https-shubhamsahu/surang-sutra-vishwakarma/cad/mass-properties.md

# SURANG-SUTRA mass properties (CAD estimate)

Generated by `cad/mass_report.py` from `cad/mass-properties.json` (written by `build_surang.py`). Everything is a design calculation: printed, moulded and composite parts are CAD volume times density; bought parts use catalogue or baseline masses. Nothing has been weighed.

Densities (g/cm³): GFRP 2.0, CF 1.6, PA12 1.0, PETG 1.27, TPU 1.2, Al 2.7, Steel 7.85, FR4 1.85, PTFE 2.2. Al standoffs, steel pins/bearings, FR4 and PTFE are not in the brief, so standard values are used.

## Summary by baseline allocation

| Group | CAD-volume mass (g) | Catalogue / allowance (g) | Total (g) | Baseline allocation (g) | Delta (g) |
|---|---:|---:|---:|---:|---:|
| Cage | 444 | 11 | **455** | 400 | +55 |
| Frame + mounts | 234 | 25 | **259** | 300 | -41 |
| Motors | 0 | 248 | **248** | 250 | -2 |
| ESC + props | 0 | 60 | **60** | 100 | -40 |
| Battery | 0 | 490 | **490** | 490 | +0 |
| FC + avionics | 0 | 104 | **104** | 100 | +4 |
| Pi + cooler | 0 | 68 | **68** | 100 | -32 |
| Sensors + lights | 0 | 83 | **83** | 140 | -57 |
| Gas package | 26 | 63 | **89** | 100 | -11 |
| Cassette + 5 pucks | 146 | 82 | **229** | 170 | +59 |
| Wiring | 0 | 80 | **80** | 80 | +0 |
| Reserve | | | | 70 | |
| **All-up** | | | **2165** | **2300** (cap 2400) | **-235** vs cap |

- All-up CAD estimate **2.17 kg**: 65 g under the 2230 g of named allocations, 135 g under allocations + 70 g reserve, and 235 g under the 2.40 kg cap.
- Thrust check at the ≥ 6 kgf target: T/W = 6.0 / 2.17 = **2.77** (target ≥ 2.5).
- Over allocation: **Cage** (+55 g) and **Cassette + 5 pucks** (+59 g). Under: ESC + props, Pi, sensors, frame, gas.

## Line items

| Group | Item | Source | Material | Mass (g) |
|---|---|---|---|---:|
| Cage | Strut (120 off) | CAD | GFRP | 278.7 |
| Cage | Hub_M6 (30 off) | CAD | PA12 | 78.5 |
| Cage | TPU hub cap (40 off) | CAD | TPU | 30.1 |
| Cage | Hub_V5 (10 off) | CAD | PA12 | 26.7 |
| Cage | PoleHub_PosY | CAD | PA12 | 12.0 |
| Cage | PoleHub_NegY | CAD | PA12 | 12.0 |
| Cage | Bearing_6800_2RS_PosY | catalogue | bought | 5.5 |
| Cage | Bearing_6800_2RS_NegY | catalogue | bought | 5.5 |
| Cage | PoleCap_NegY | CAD | TPU | 3.2 |
| Cage | PoleCap_PosY | CAD | TPU | 3.2 |
| Frame + mounts | Plate_Bottom | CAD | CF | 27.4 |
| Frame + mounts | Plate_Top | CAD | CF | 27.4 |
| Frame + mounts | Axle | CAD | CF | 25.8 |
| Frame + mounts | Fasteners_allowance | catalogue | bought | 25.0 |
| Frame + mounts | Arm_FL | CAD | CF | 21.5 |
| Frame + mounts | Arm_FR | CAD | CF | 21.5 |
| Frame + mounts | Arm_RL | CAD | CF | 21.5 |
| Frame + mounts | Arm_RR | CAD | CF | 21.5 |
| Frame + mounts | Nose_Bracket | CAD | PA12 | 19.0 |
| Frame + mounts | Plate_Deck | CAD | CF | 14.0 |
| Frame + mounts | Standoffs_Stack_Posts | CAD | Al | 11.5 |
| Frame + mounts | LiDAR_Mast | CAD | PA12 | 10.9 |
| Frame + mounts | AxleClamp_PosY | CAD | PA12 | 4.5 |
| Frame + mounts | AxleClamp_NegY | CAD | PA12 | 4.5 |
| Frame + mounts | Standoffs_Deck_M3 | CAD | Al | 3.6 |
| Motors | Motor_FR | catalogue | bought | 62.0 |
| Motors | Motor_FL | catalogue | bought | 62.0 |
| Motors | Motor_RL | catalogue | bought | 62.0 |
| Motors | Motor_RR | catalogue | bought | 62.0 |
| ESC + props | ESC_4in1_6S | catalogue | bought | 28.0 |
| ESC + props | Prop_FR | catalogue | bought | 8.0 |
| ESC + props | Prop_FL | catalogue | bought | 8.0 |
| ESC + props | Prop_RL | catalogue | bought | 8.0 |
| ESC + props | Prop_RR | catalogue | bought | 8.0 |
| Battery | Battery_6S_3300 | catalogue | bought | 490.0 |
| FC + avionics | FC_Pixhawk6C_Mini | catalogue | bought | 39.2 |
| FC + avionics | PowerModule_Buck | catalogue | bought | 30.0 |
| FC + avionics | RadioPod_ESP32C3_LoRa_RX | catalogue | bought | 27.0 |
| FC + avionics | LoRa_Antenna_868 | catalogue | bought | 8.0 |
| Pi + cooler | Pi5_Board | catalogue | bought | 46.0 |
| Pi + cooler | Pi5_ActiveCooler | catalogue | bought | 22.0 |
| Sensors + lights | LiDAR_STL19P | catalogue | bought | 47.0 |
| Sensors + lights | Camera_IMX327 | catalogue | bought | 15.0 |
| Sensors + lights | Sensor_harness_mounts_allowance | catalogue | bought | 10.0 |
| Sensors + lights | Thermal_MLX90640 | catalogue | bought | 5.0 |
| Sensors + lights | IR_LED_850nm_R | catalogue | bought | 3.0 |
| Sensors + lights | IR_LED_850nm_L | catalogue | bought | 3.0 |
| Gas package | Gas_Sensors_O2_CO_H2S | catalogue | bought | 36.0 |
| Gas package | Gas_Pump | catalogue | bought | 25.0 |
| Gas package | Gas_FlowCell | CAD | PA12 | 22.2 |
| Gas package | GasInlet_Tube | CAD | PTFE | 3.4 |
| Gas package | GasInlet_Filter | catalogue | bought | 2.0 |
| Cassette + 5 pucks | 5 pucks: LiPo_1S_400 | catalogue | bought | 42.5 |
| Cassette + 5 pucks | 5 pucks: Shell_Lid | CAD | PETG | 33.7 |
| Cassette + 5 pucks | 5 pucks: Shell_Base | CAD | PETG | 28.9 |
| Cassette + 5 pucks | 5 pucks: PCB | CAD | FR4 | 26.8 |
| Cassette + 5 pucks | Cassette_Tube | CAD | PETG | 18.2 |
| Cassette + 5 pucks | 5 pucks: Bumper_TPU | CAD | TPU | 16.3 |
| Cassette + 5 pucks | Servo_MG90S | catalogue | bought | 13.4 |
| Cassette + 5 pucks | Cassette_TopCap | CAD | PA12 | 10.7 |
| Cassette + 5 pucks | 5 pucks: RFM95W_868 | catalogue | bought | 7.5 |
| Cassette + 5 pucks | BreakBeam_Collar | CAD | PA12 | 6.4 |
| Cassette + 5 pucks | 5 pucks: ESP32C3_MINI1 | catalogue | bought | 5.0 |
| Cassette + 5 pucks | 5 pucks: AprilTag | catalogue | bought | 4.0 |
| Cassette + 5 pucks | 5 pucks: Antenna_Stub | catalogue | bought | 3.0 |
| Cassette + 5 pucks | 5 pucks: Passives_LED_Hall | catalogue | bought | 3.0 |
| Cassette + 5 pucks | BreakBeam_IR_Pair | catalogue | bought | 2.0 |
| Cassette + 5 pucks | 5 pucks: ChargePads | catalogue | bought | 2.0 |
| Cassette + 5 pucks | Servo_Bracket | CAD | PA12 | 1.9 |
| Cassette + 5 pucks | Pin_Release | CAD | Steel | 1.4 |
| Cassette + 5 pucks | Pin_Capture | CAD | Steel | 1.2 |
| Cassette + 5 pucks | Escapement_Cam | CAD | PA12 | 0.9 |
| Wiring | Wiring_allowance | catalogue | bought | 80.0 |

## Centre of gravity

Origin = cage centre = axle centreline. X forward (nose), Y along the axle, Z up. Cage in its rest pose.

| Assembly | Mass (g) | CG x (mm) | CG y (mm) | CG z (mm) |
|---|---:|---:|---:|---:|
| All-up | 2165 | 0.0 | 4.6 | -12.4 |
| Hanging core (everything except the cage) | 1710 | 0.0 | 5.8 | -15.7 |
| Cage (rotates on the bearings) | 455 | 0.0 | 0.0 | 0.0 |

- The battery is placed at x = -9.0 mm by the build script so the hanging core balances fore-aft (x_CG = 0), which keeps the frame level on the axle.
- The hanging core CG sits **15.7 mm below the axle**: pendulum-stable but a short arm (restoring moment ≈ 0.26 N·m per radian of tilt). Lowering the battery or cassette would lengthen it.
- Lateral CG y = +5.8 mm (core) comes from the cassette offset to +54 mm (see README, puck exit). It falls as pucks are dropped; the FC trims it in flight, or the gas package can move further to −Y.

Inertia about the all-up CG (kg·m², solids at uniform density, bought blocks scaled to catalogue mass):

| | x | y | z |
|---|---:|---:|---:|
| x | 0.0338 | 0.0000 | -0.0003 |
| y | 0.0000 | 0.0307 | 0.0008 |
| z | -0.0003 | 0.0008 | 0.0360 |

## SUTRA puck (one)

| Part | Source | Material | Mass (g) |
|---|---|---|---:|
| Shell_Base | CAD | PETG | 5.8 |
| Shell_Lid | CAD | PETG | 6.7 |
| Bumper_TPU | CAD | TPU | 3.3 |
| PCB | CAD | FR4 | 5.4 |
| LiPo_1S_400 | catalogue | bought | 8.5 |
| ESP32C3_MINI1 | catalogue | bought | 1.0 |
| RFM95W_868 | catalogue | bought | 1.5 |
| Antenna_Stub | catalogue | bought | 0.6 |
| ChargePads | catalogue | bought | 0.4 |
| Passives_LED_Hall | catalogue | bought | 0.6 |
| screws + tag label (allowance) | catalogue | | 0.8 |
| **Total** | | | **34.5** (target ≤ 30) |

Puck CG 8.0 mm above the base. Getting under 30 g, calculated: PETG walls 1.4 → 1.0 mm (about −3.5 g) and a 1.0 mm PCB instead of 1.6 mm (about −2 g) give about 29 g.

Catalogue masses used (approximate, class values, check against the purchased parts): 2809 motor 62 g, HQ 7x4x3 prop 8 g, 4-in-1 6S ESC 28 g, 6S 3300 mAh pack 490 g (baseline), Pixhawk 6C Mini 39.2 g, power module + buck 30 g, ESP32-C3 + RFM95W + receiver 27 g, 868 MHz antenna 8 g, Raspberry Pi 5 46 g, active cooler 22 g, STL-19P LiDAR 47 g, IMX327 module 15 g, MLX90640 5 g, IR LED + optic 3 g each, gas cells 36 g (3), sampling pump 25 g, MG90S 13.4 g, 6800-2RS bearing 5.5 g, 1S 400 mAh LiPo 8.5 g. Allowances: fasteners 25 g, sensor harness/mounts 10 g, wiring 80 g (baseline).
