https-shubhamsahu/surang-sutra-vishwakarma/electronics/exports/surang-avionics-deck.png

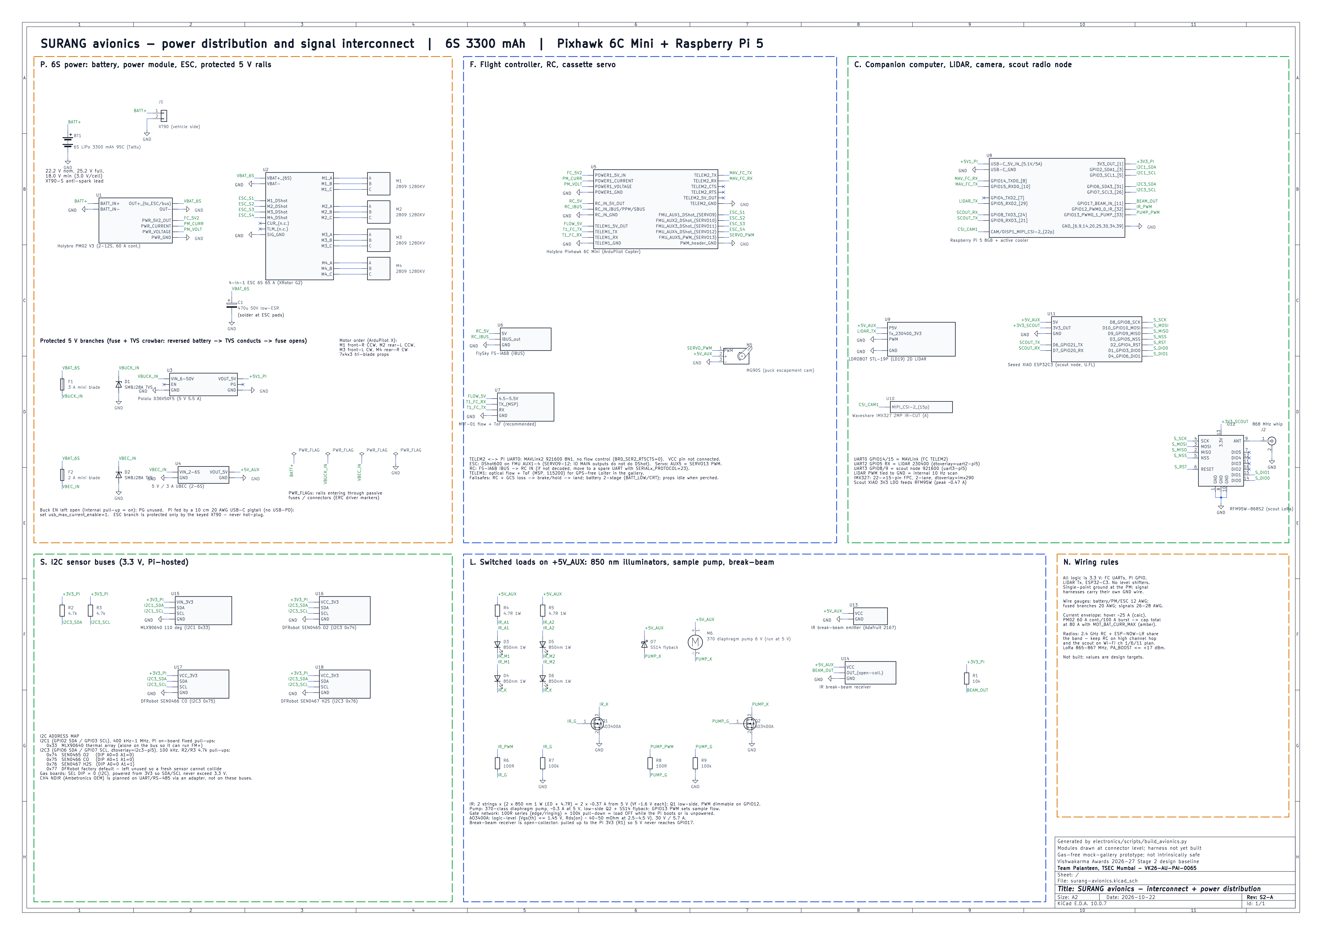
electronics/exports/surang-avionics-deck.png
