https-shubhamsahu/surang-sutra-vishwakarma/electronics/exports/sutra-puck-deck.png

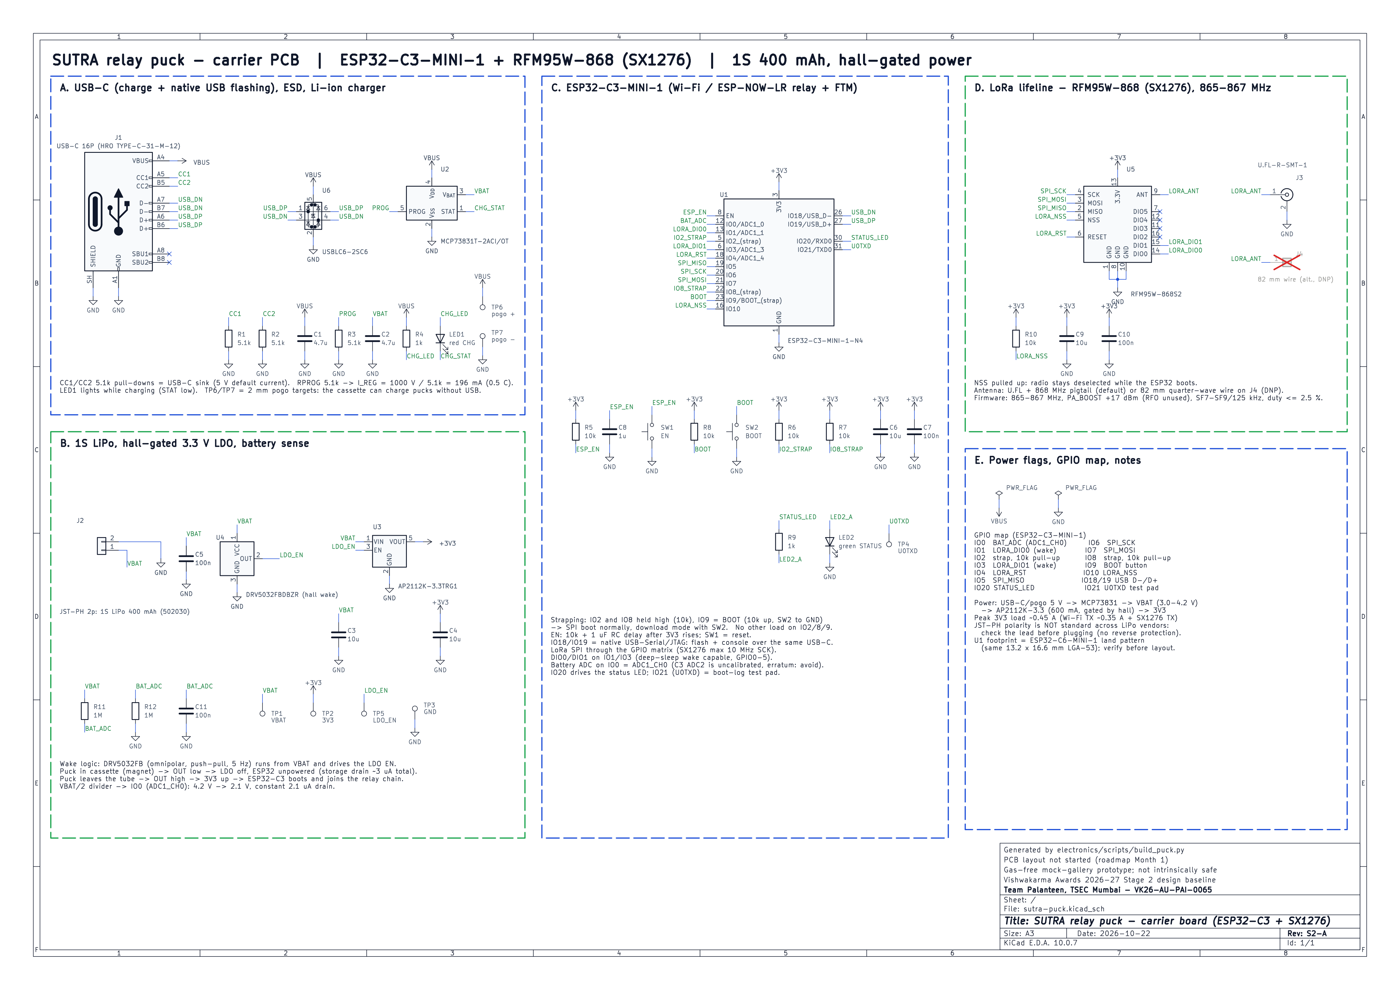
electronics/exports/sutra-puck-deck.png
