https-shubhamsahu/surang-sutra-vishwakarma/electronics/pinmap.png

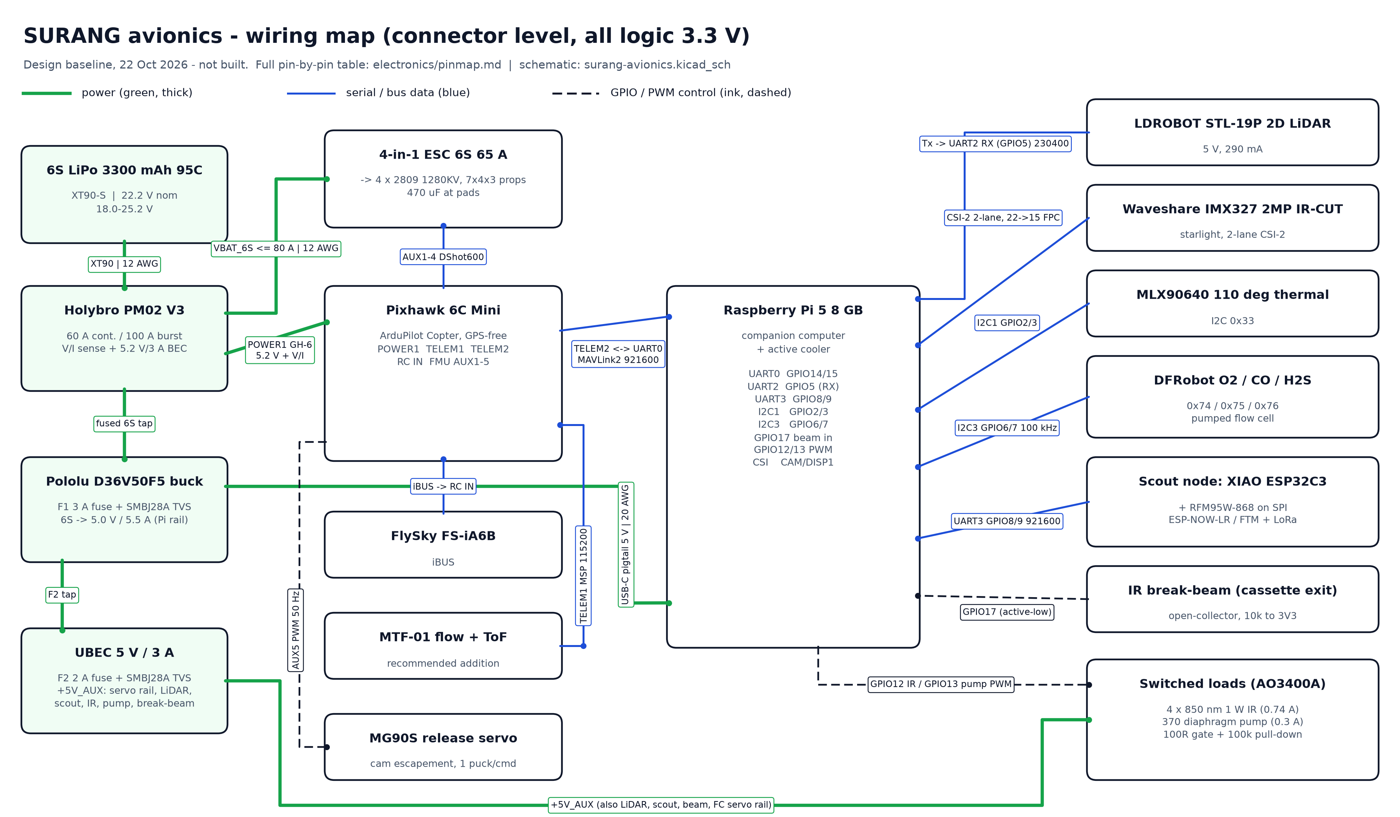
electronics/pinmap.png
