https-shubhamsahu/surang-sutra-vishwakarma/electronics/power-budget.png

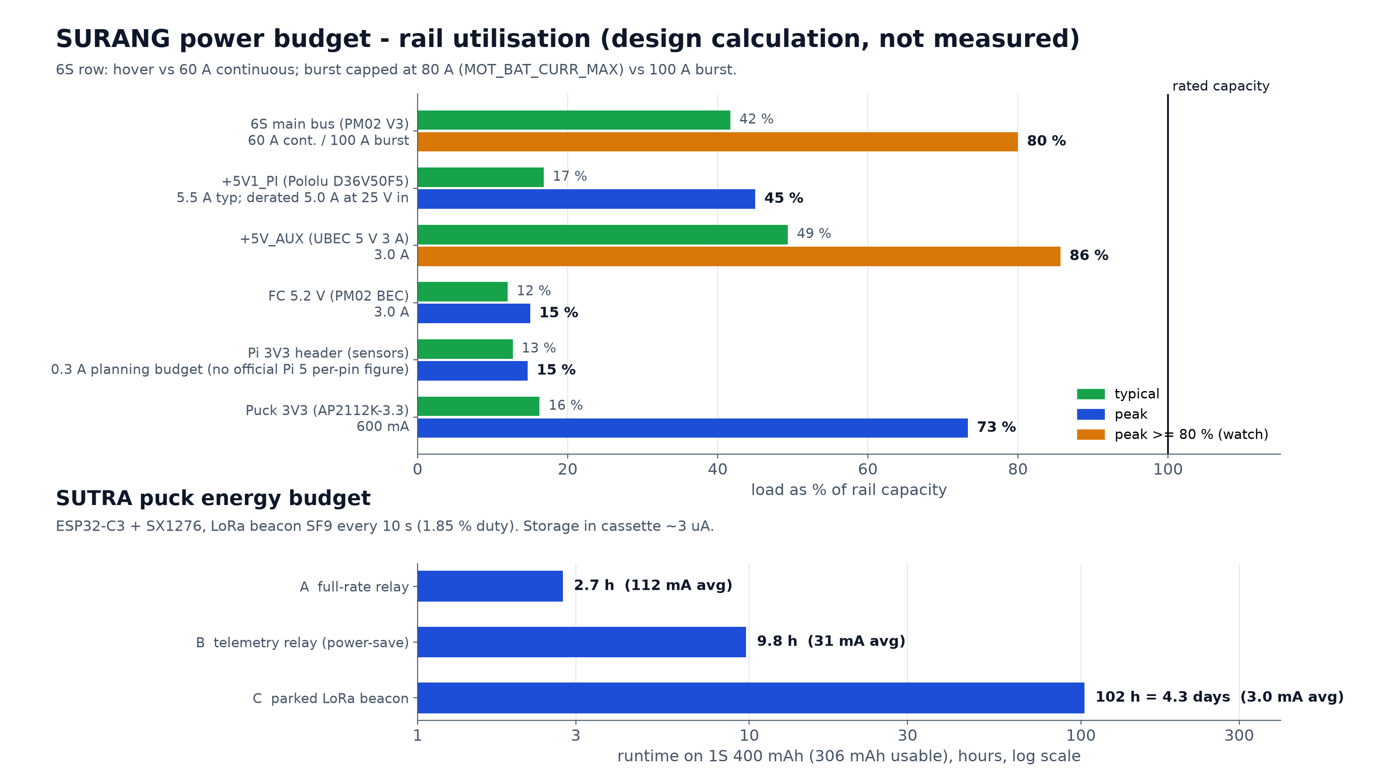
electronics/power-budget.png
