https-shubhamsahu/surang-sutra-vishwakarma/fea/figures/fea-cage-stress.png

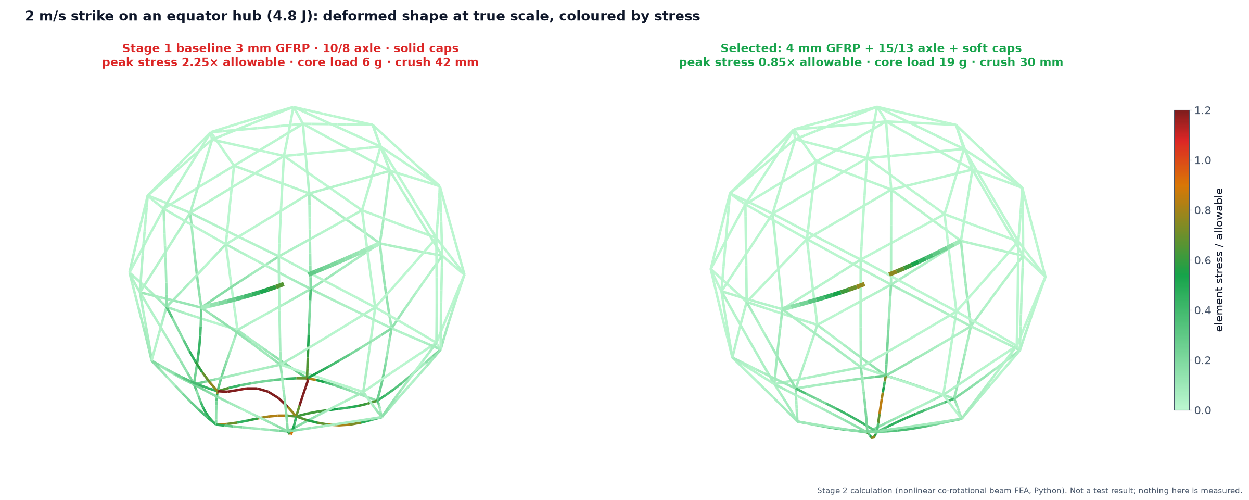
fea/figures/fea-cage-stress.png
