https-shubhamsahu/surang-sutra-vishwakarma/fea/figures/fea-convergence.png

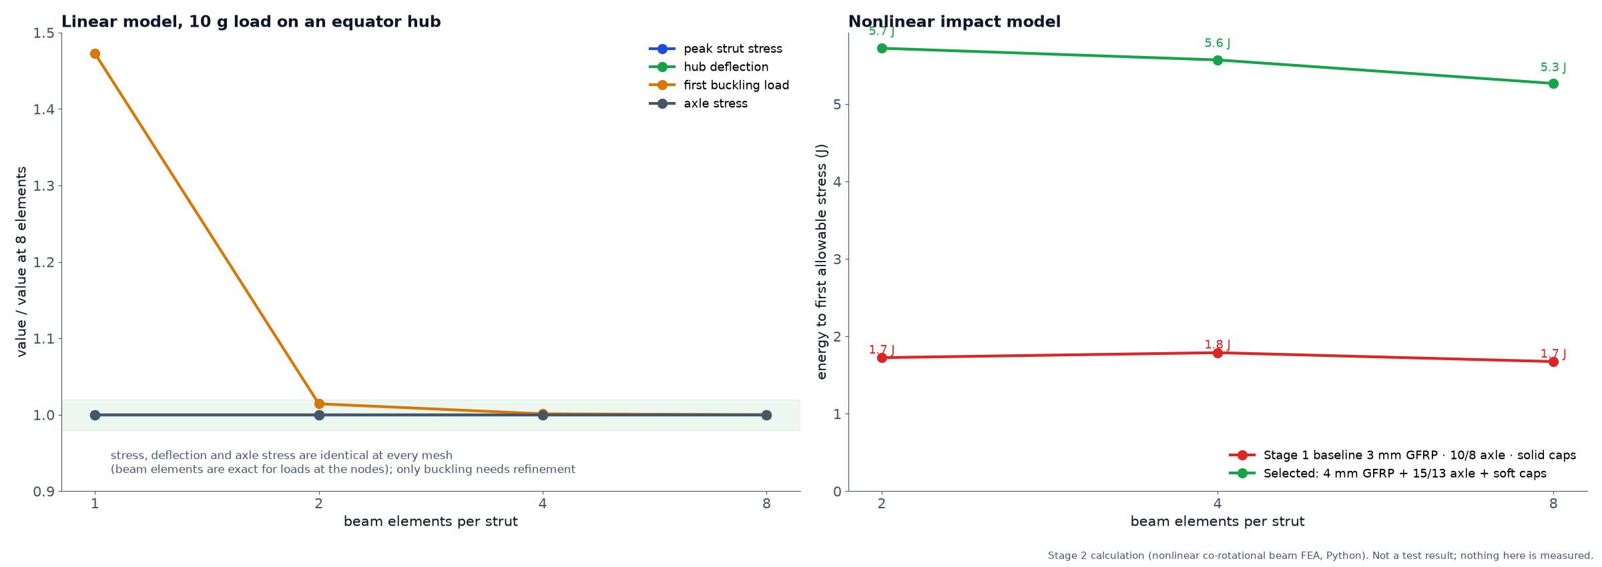
fea/figures/fea-convergence.png
