https-shubhamsahu/surang-sutra-vishwakarma/fea/figures/fea-design-ladder.png

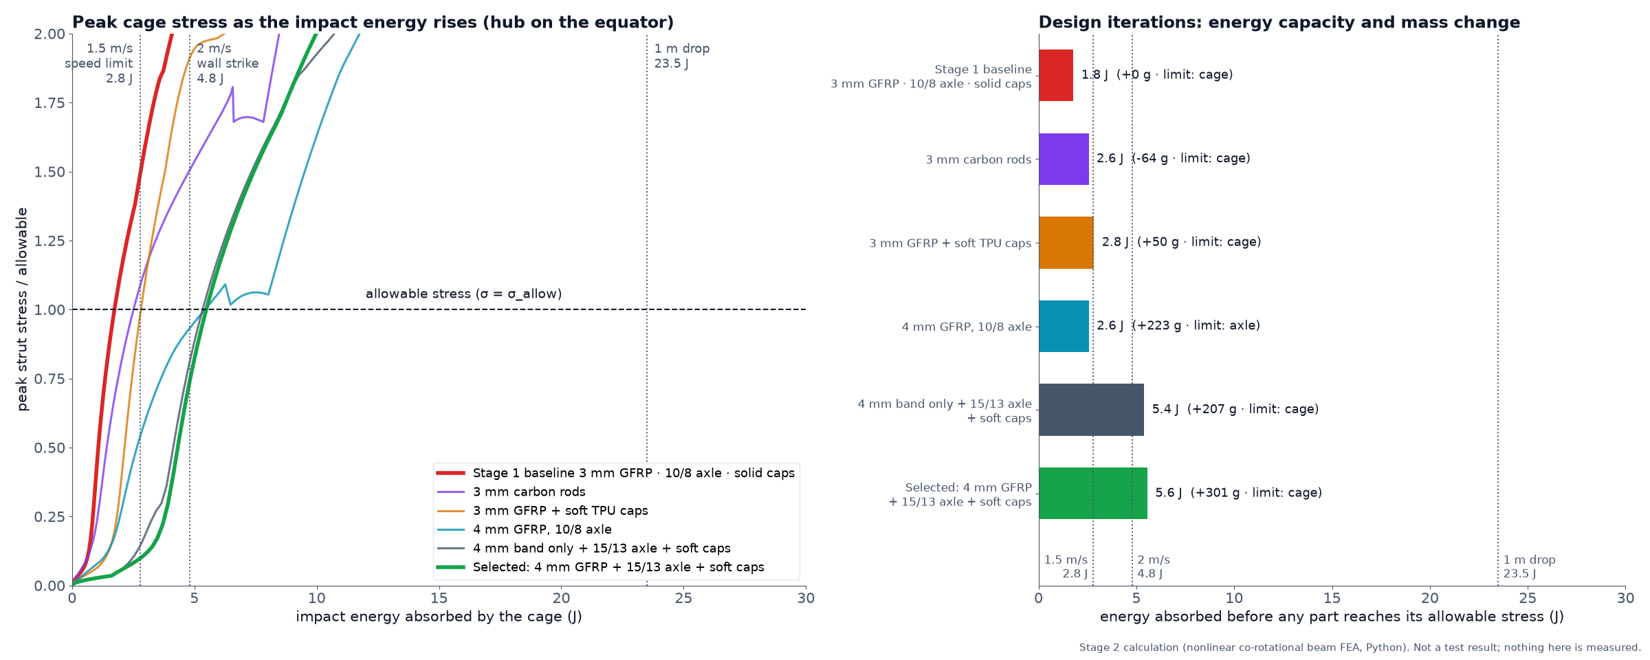
fea/figures/fea-design-ladder.png
