https-shubhamsahu/surang-sutra-vishwakarma/renders/_raw/bottom.png

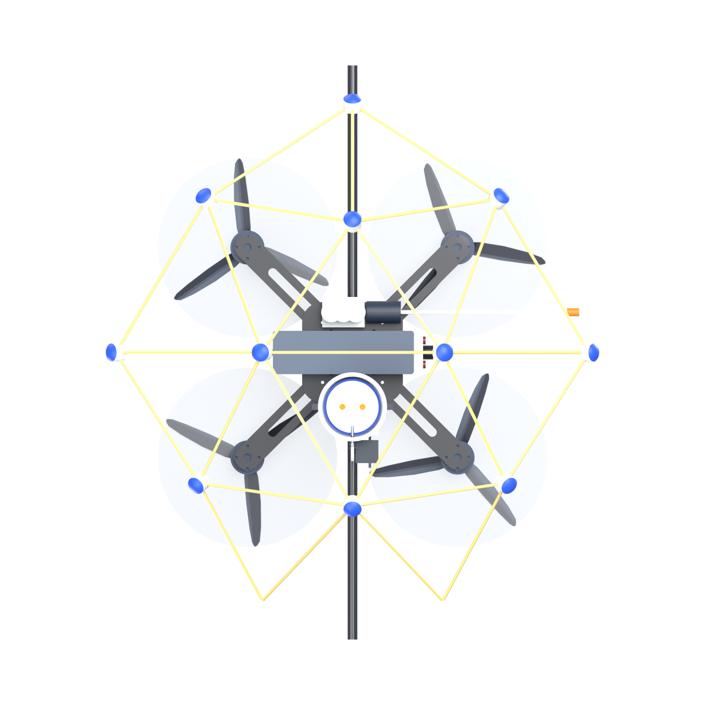
renders/_raw/bottom.png
