https-shubhamsahu/surang-sutra-vishwakarma/renders/_raw/cutaway.png

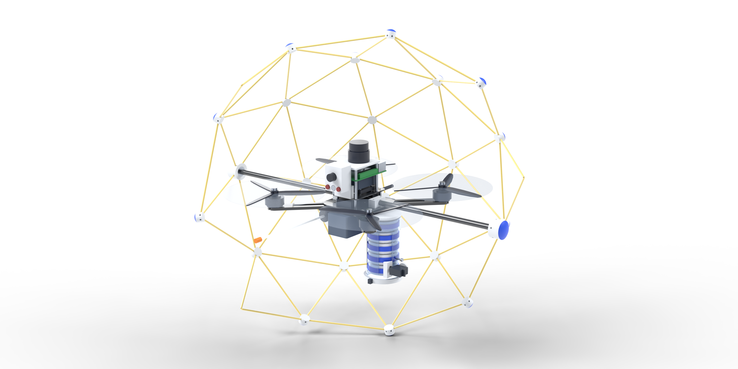
renders/_raw/cutaway.png
