https-shubhamsahu/surang-sutra-vishwakarma/renders/_raw/exploded.png

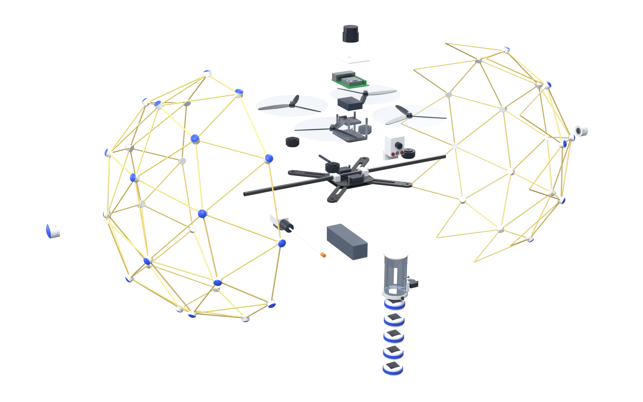
renders/_raw/exploded.png
