https-shubhamsahu/surang-sutra-vishwakarma/renders/_raw/hero.png

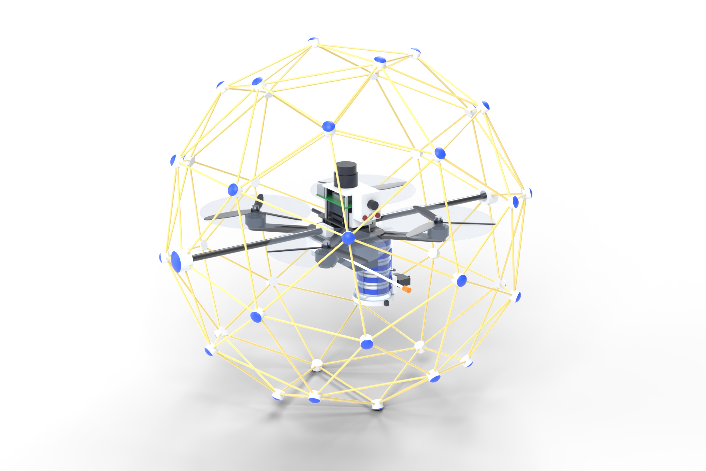
renders/_raw/hero.png
