https-shubhamsahu/surang-sutra-vishwakarma/renders/_raw/plan.png

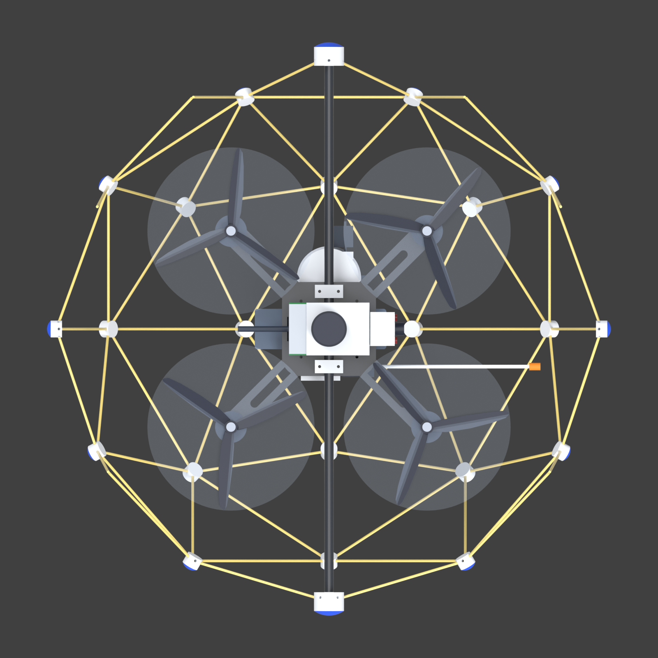
renders/_raw/plan.png
