https-shubhamsahu/surang-sutra-vishwakarma/renders/_raw/puck.png

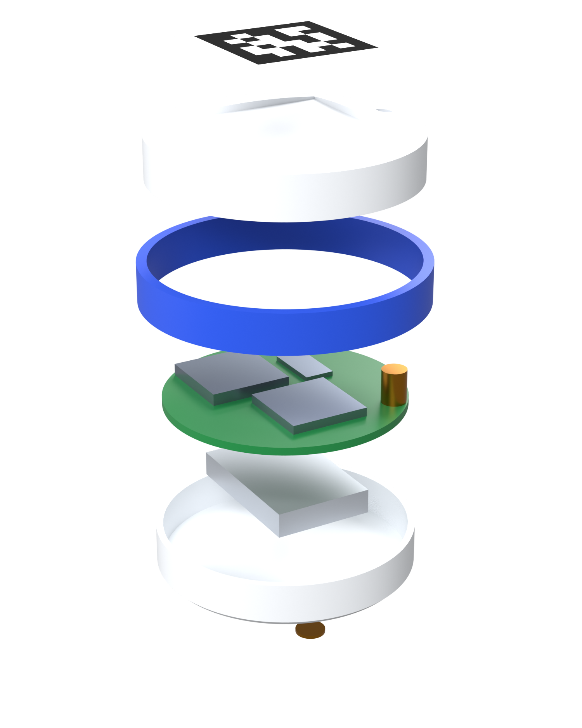
renders/_raw/puck.png
