https-shubhamsahu/surang-sutra-vishwakarma/renders/_raw/side.png

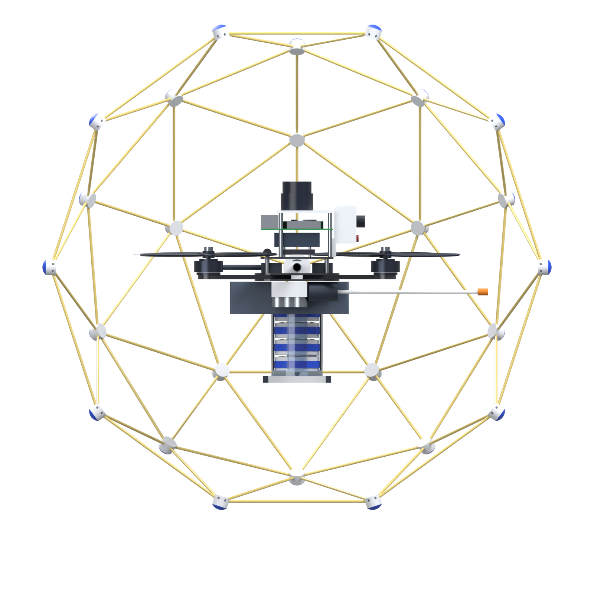
renders/_raw/side.png
