https-shubhamsahu/surang-sutra-vishwakarma/renders/freecad-ui.png

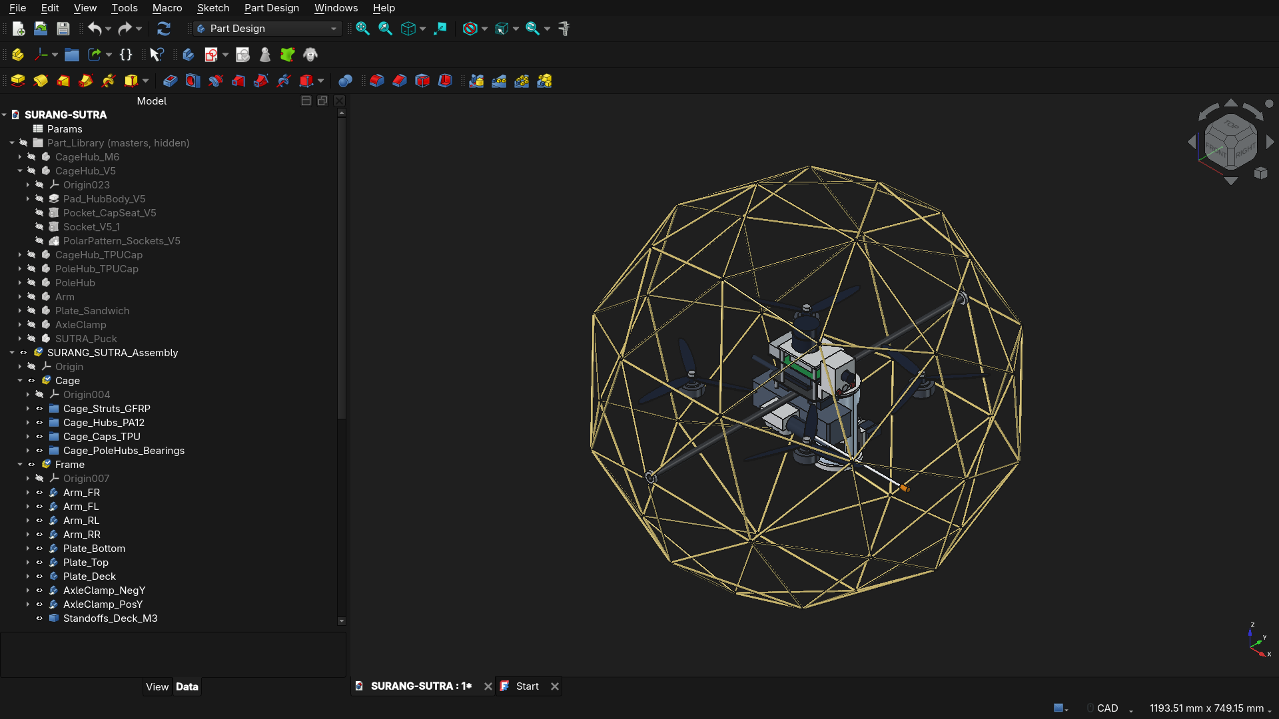
renders/freecad-ui.png
