https-shubhamsahu/surang-sutra-vishwakarma/renders/puck-exit-check.png

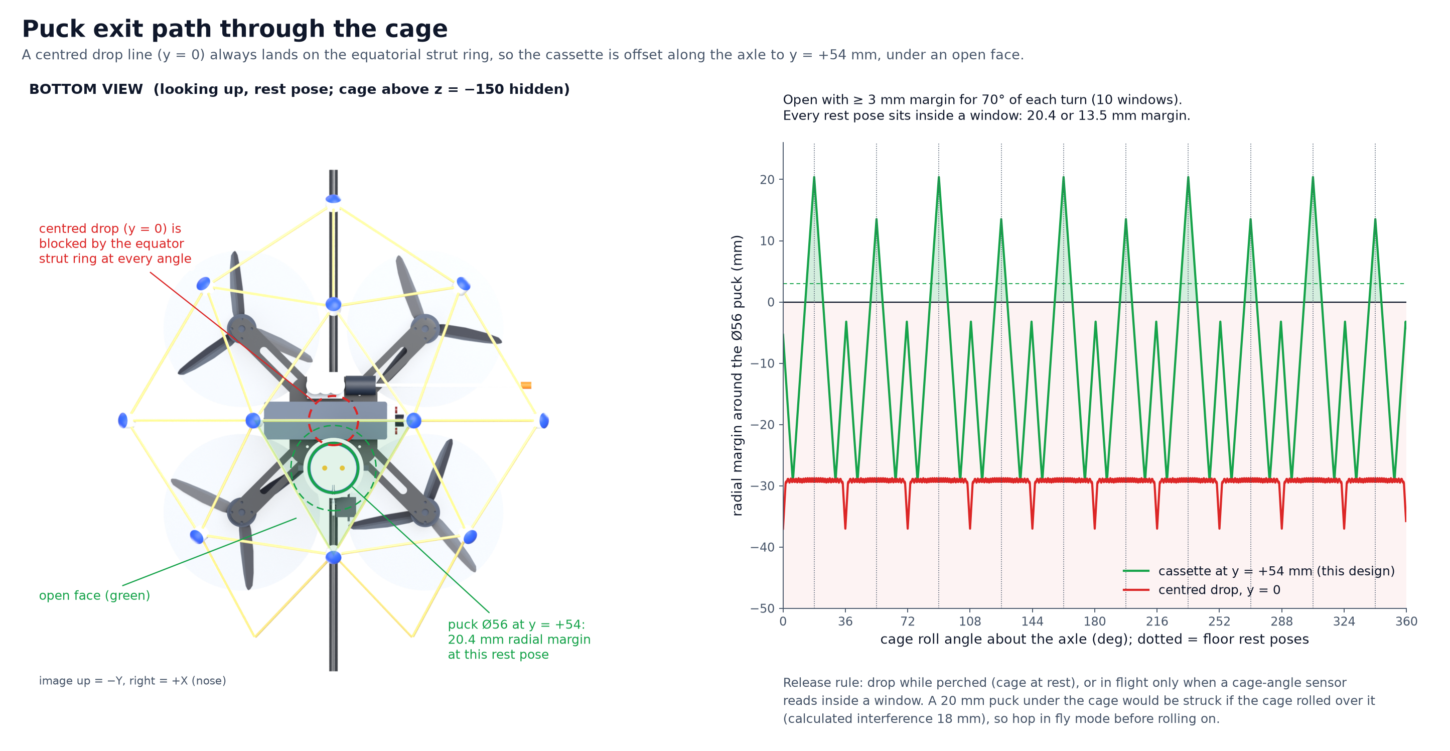
renders/puck-exit-check.png
