https-shubhamsahu/surang-sutra-vishwakarma/renders/surang-cutaway.png

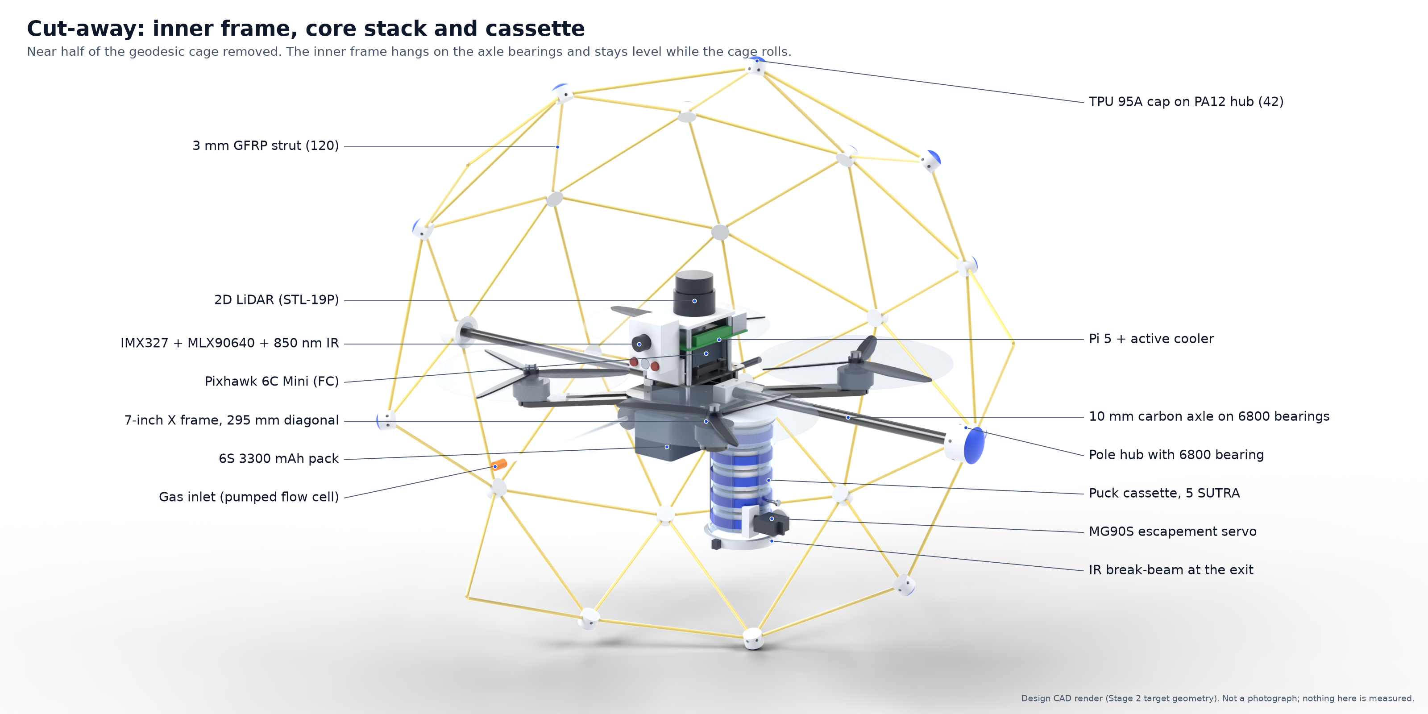
renders/surang-cutaway.png
