https-shubhamsahu/surang-sutra-vishwakarma/renders/surang-exploded.png

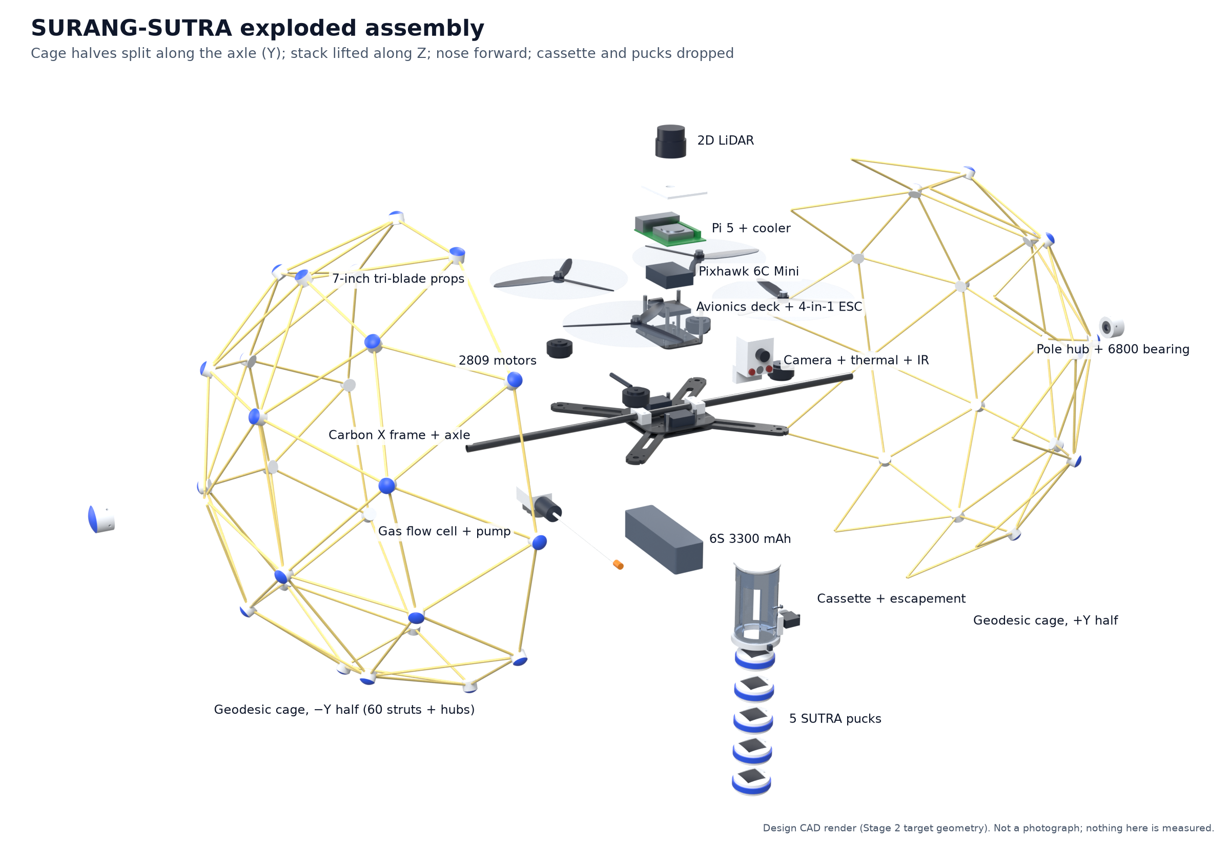
renders/surang-exploded.png
