https-shubhamsahu/surang-sutra-vishwakarma/renders/surang-side-plan-dimensions.png

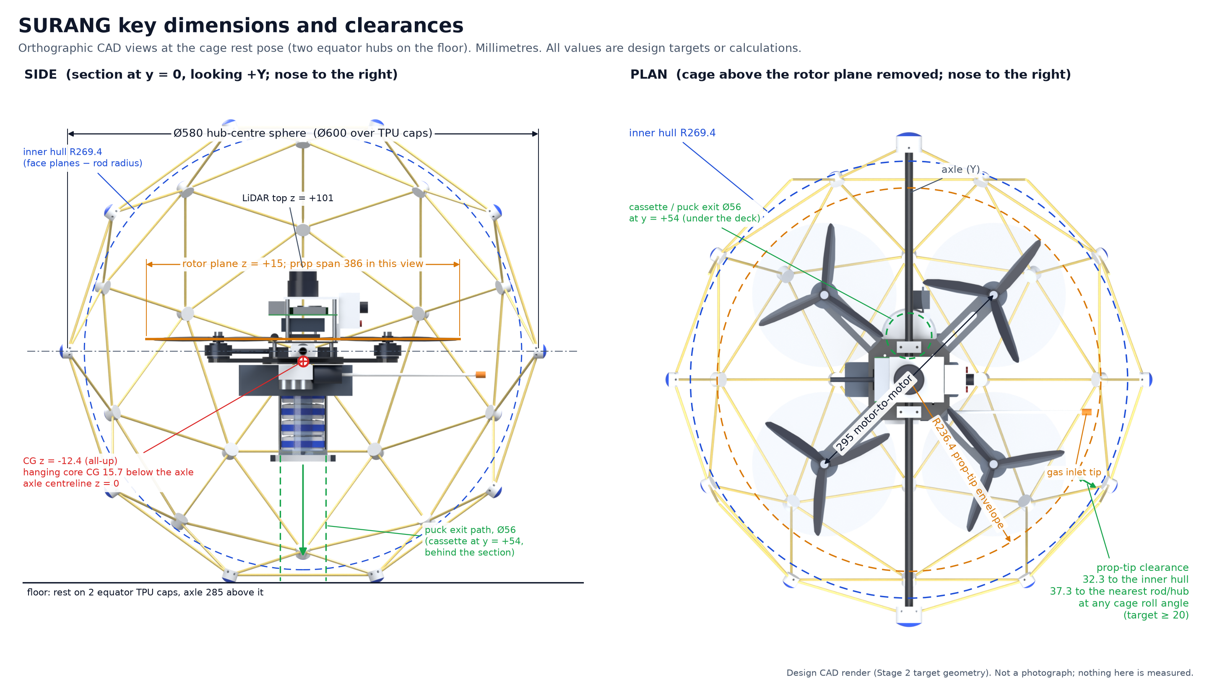
renders/surang-side-plan-dimensions.png
