https-shubhamsahu/surang-sutra-vishwakarma/renders/sutra-puck-exploded.png

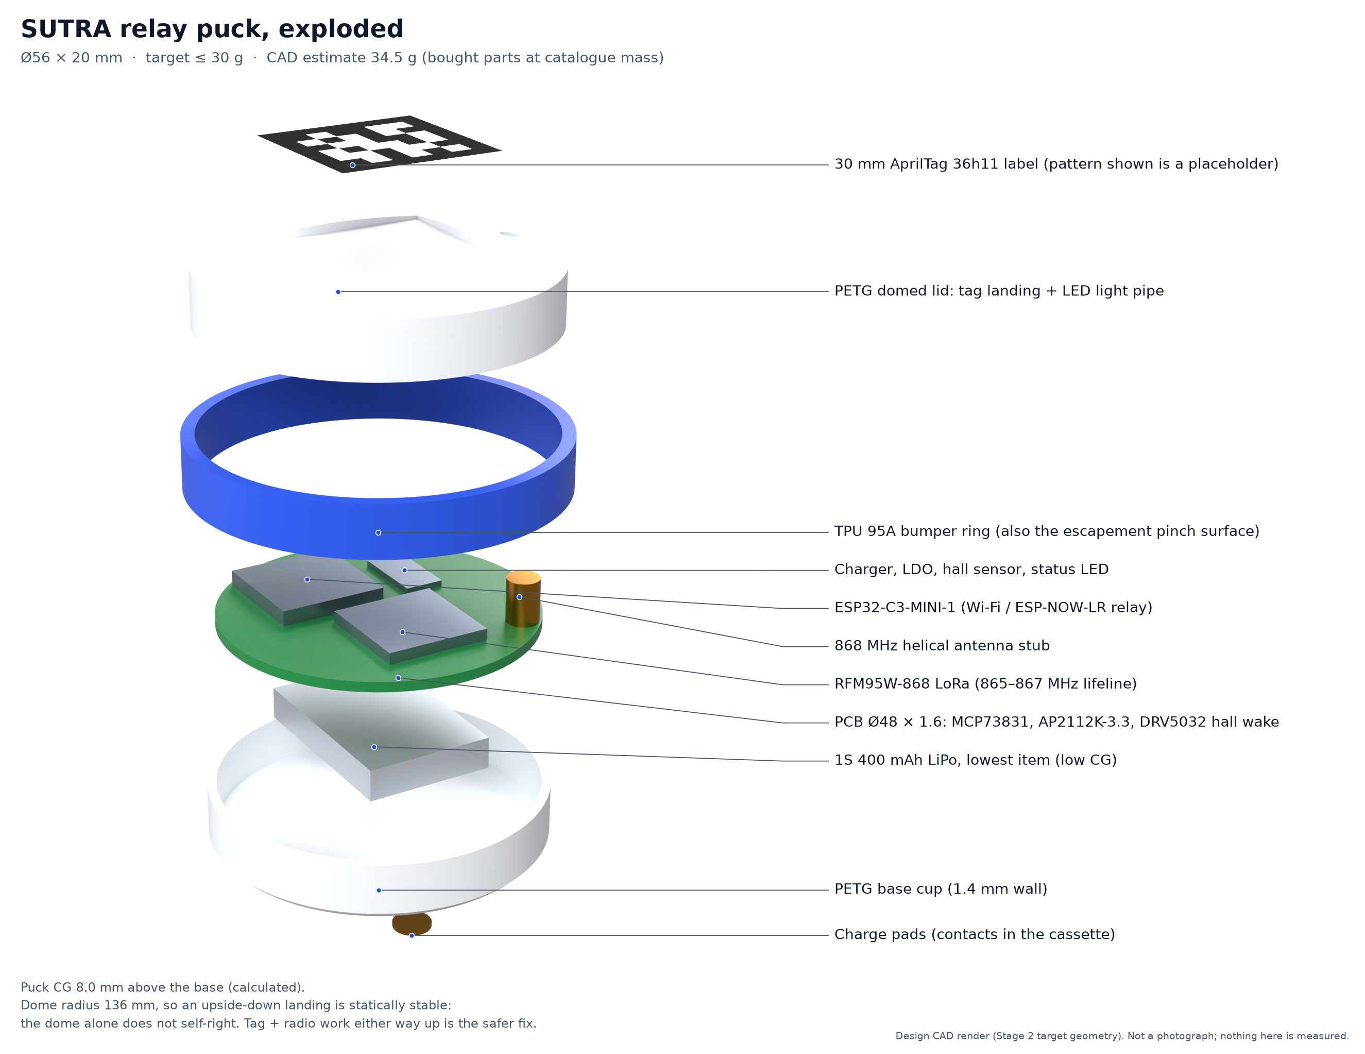
renders/sutra-puck-exploded.png
