https-shubhamsahu/surang-sutra-vishwakarma/electronics/exports/surang-avionics-bom-kicad.csv

Refs | Value | MPN | Footprint | Qty | DNP
BT1 | 6S LiPo 3300 mAh 95C (Tattu) | TAS33006S95X9 |  | 1
C1 | 470u 50V low-ESR | Panasonic EEU-FR1H471 | Capacitor_THT:CP_Radial_D10.0mm_P5.00mm | 1
D1,D2 | SMBJ28A TVS | SMBJ28A | Diode_SMD:D_SMB | 2
D3,D4,D5,D6 | 850nm 1W |  | LED_SMD:LED_1W_3W_R8 | 4
D7 | SS14 flyback | SS14 | Diode_SMD:D_SMA | 1
F1 | 3 A mini blade | Littelfuse 0297003 | Fuse:Fuse_Blade_Mini_directSolder | 1
F2 | 2 A mini blade | Littelfuse 0297002 | Fuse:Fuse_Blade_Mini_directSolder | 1
J1 | XT90 (vehicle side) | AMASS XT90H | Connector_AMASS:AMASS_XT90PW-M_1x02_P10.90mm_Horizontal | 1
J2 | 868 MHz whip |  | Connector_Coaxial:U.FL_Hirose_U.FL-R-SMT-1_Vertical | 1
M1,M2,M3,M4 | 2809 1280KV | GEPRC SPEEDX2 2809 1280KV |  | 4
M5 | MG90S (puck escapement cam) | MG90S |  | 1
M6 | 370 diaphragm pump 6 V (run at 5 V) | 370 micro air pump |  | 1
Q1,Q2 | AO3400A | AO3400A | Package_TO_SOT_SMD:SOT-23 | 2
R1 | 10k |  | Resistor_SMD:R_0603_1608Metric | 1
R2,R3 | 4.7k |  | Resistor_SMD:R_0603_1608Metric | 2
R4,R5 | 4.7R 1W | 2512 4.7R 1W | Resistor_SMD:R_2512_6332Metric | 2
R6,R8 | 100R |  | Resistor_SMD:R_0603_1608Metric | 2
R7,R9 | 100k |  | Resistor_SMD:R_0603_1608Metric | 2
U1 | Holybro PM02 V3 (2-12S, 60 A cont.) | Holybro PM02 V3 |  | 1
U2 | 4-in-1 ESC 6S 65 A (XRotor G2) | Hobbywing XRotor G2 65A 4in1 |  | 1
U3 | Pololu D36V50F5 (5 V 5.5 A) | Pololu #4091 |  | 1
U4 | 5 V / 3 A UBEC (2-6S) | ReadytoSky 2-6S 5V3A UBEC |  | 1
U5 | Holybro Pixhawk 6C Mini (ArduPilot Copter) | Holybro Pixhawk 6C Mini |  | 1
U6 | FlySky FS-iA6B (iBUS) | FlySky FS-iA6B |  | 1
U7 | MTF-01 flow + ToF (recommended) | MicoAir MTF-01 |  | 1
U8 | Raspberry Pi 5 8GB + active cooler | SC1112 |  | 1
U9 | LDROBOT STL-19P (LD19) 2D LiDAR | STL-19P / D500 kit |  | 1
U10 | Waveshare IMX327 2MP IR-CUT (A) | Waveshare 23752 |  | 1
U11 | Seeed XIAO ESP32C3 (scout node, U.FL) | Seeed 113991054 |  | 1
U12 | RFM95W-868S2 (scout LoRa) | RFM95W-868S2 | RF_Module:HOPERF_RFM9XW_SMD | 1
U13 | IR break-beam emitter (Adafruit 2167) | Adafruit 2167 |  | 1
U14 | IR break-beam receiver | Adafruit 2167 |  | 1
U15 | MLX90640 110 deg (I2C1 0x33) | 7Semi MLX90640 110deg |  | 1
U16 | DFRobot SEN0465 O2 (I2C3 0x74) | DFRobot SEN0465 |  | 1
U17 | DFRobot SEN0466 CO (I2C3 0x75) | DFRobot SEN0466 |  | 1
U18 | DFRobot SEN0467 H2S (I2C3 0x76) | DFRobot SEN0467 |  | 1
