https-shubhamsahu/surang-sutra-vishwakarma/electronics/exports/sutra-puck-bom-kicad.csv

Refs | Value | MPN | Footprint | Qty | DNP
C1,C2 | 4.7u | X5R 10V 0805 | Capacitor_SMD:C_0805_2012Metric | 2
C3,C4,C6,C9 | 10u | X5R 10V 0805 | Capacitor_SMD:C_0805_2012Metric | 4
C5,C7,C10,C11 | 100n | X7R 16V 0603 100n | Capacitor_SMD:C_0603_1608Metric | 4
C8 | 1u | X7R 16V 0603 1u | Capacitor_SMD:C_0603_1608Metric | 1
J1 | USB-C 16P (HRO TYPE-C-31-M-12) | TYPE-C-31-M-12 | Connector_USB:USB_C_Receptacle_HRO_TYPE-C-31-M-12 | 1
J2 | JST-PH 2p: 1S LiPo 400 mAh (502030) | S2B-PH-SM4-TB | Connector_JST:JST_PH_S2B-PH-SM4-TB_1x02-1MP_P2.00mm_Horizontal | 1
J3 | U.FL-R-SMT-1 | U.FL-R-SMT-1(10) | Connector_Coaxial:U.FL_Hirose_U.FL-R-SMT-1_Vertical | 1
J4 | 82 mm wire (alt., DNP) |  | Connector_Wire:SolderWire-0.127sqmm_1x01_D0.48mm_OD1mm | 1 | DNP
LED1 | red CHG | red 0603 | LED_SMD:LED_0603_1608Metric | 1
LED2 | green STATUS | green 0603 | LED_SMD:LED_0603_1608Metric | 1
R1,R2,R3 | 5.1k | 0603 5.1k 1% | Resistor_SMD:R_0603_1608Metric | 3
R4,R9 | 1k | 0603 1k 1% | Resistor_SMD:R_0603_1608Metric | 2
R5,R6,R7,R8,R10 | 10k | 0603 10k 1% | Resistor_SMD:R_0603_1608Metric | 5
R11,R12 | 1M | 0603 1M 1% | Resistor_SMD:R_0603_1608Metric | 2
SW1 | EN | C&K KMR221G | Button_Switch_SMD:SW_Push_1P1T_NO_CK_KMR2 | 1
SW2 | BOOT | C&K KMR221G | Button_Switch_SMD:SW_Push_1P1T_NO_CK_KMR2 | 1
U1 | ESP32-C3-MINI-1-N4 | ESP32-C3-MINI-1-N4 | RF_Module:ESP32-C6-MINI-1 | 1
U2 | MCP73831T-2ACI/OT | MCP73831T-2ACI/OT | Package_TO_SOT_SMD:SOT-23-5 | 1
U3 | AP2112K-3.3TRG1 | AP2112K-3.3TRG1 | Package_TO_SOT_SMD:SOT-23-5 | 1
U4 | DRV5032FBDBZR (hall wake) | DRV5032FBDBZR | Package_TO_SOT_SMD:SOT-23 | 1
U5 | RFM95W-868S2 | RFM95W-868S2 | RF_Module:HOPERF_RFM9XW_SMD | 1
U6 | USBLC6-2SC6 | USBLC6-2SC6 | Package_TO_SOT_SMD:SOT-23-6 | 1
