https-shubhamsahu/surang-sutra-vishwakarma/cad/mesh/assembly.obj

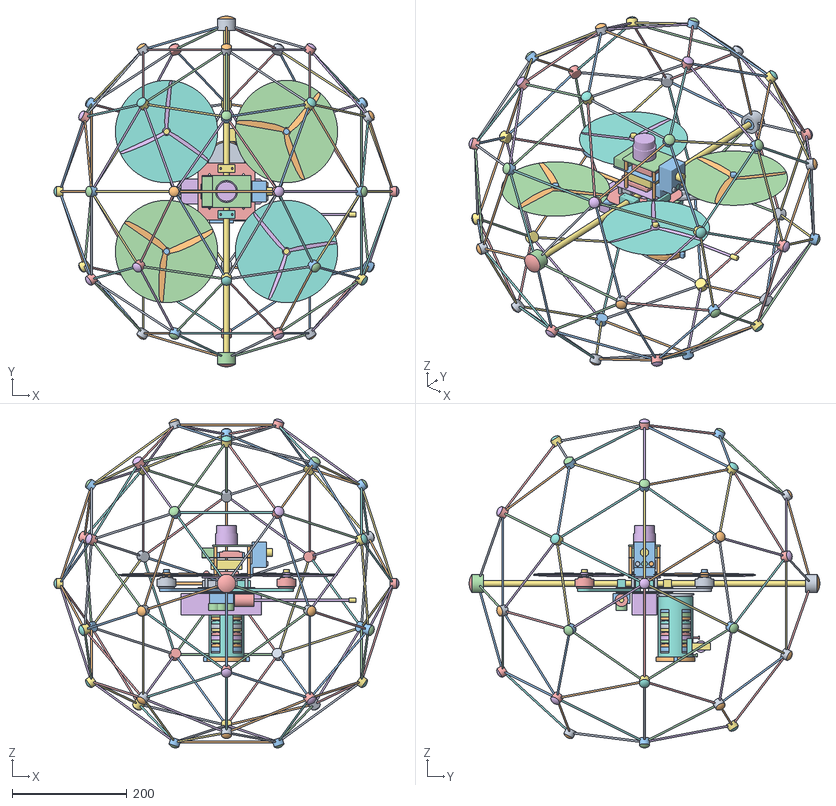
[picture p21: CAD file, 2026-10-24]
cad/mesh/assembly.obj
600.0 x 610.0 x 571.8
Strut_000
Strut_001
Strut_002
Strut_003
Strut_004
Strut_005
Strut_006
Strut_007
Strut_008
Strut_009
Strut_010
Strut_011
Strut_012
Strut_013
Strut_014
Strut_015
Strut_016
Strut_017
Strut_018
Strut_019
Strut_020
Strut_021
Strut_022
Strut_023
Strut_024
Strut_025
Strut_026
Strut_027
Strut_028
Strut_029
Strut_030
Strut_031
Strut_032
Strut_033
Strut_034
Strut_035
Strut_036
Strut_037
Strut_038
Strut_039
Strut_040
Strut_041
Strut_042
Strut_043
Strut_044
Strut_045
Strut_046
Strut_047
Strut_048
Strut_049
Strut_050
Strut_051
Strut_052
Strut_053
Strut_054
Strut_055
Strut_056
Strut_057
Strut_058
Strut_059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
