https-shubhamsahu/surang-sutra-vishwakarma/cad/step/pole-hub.step

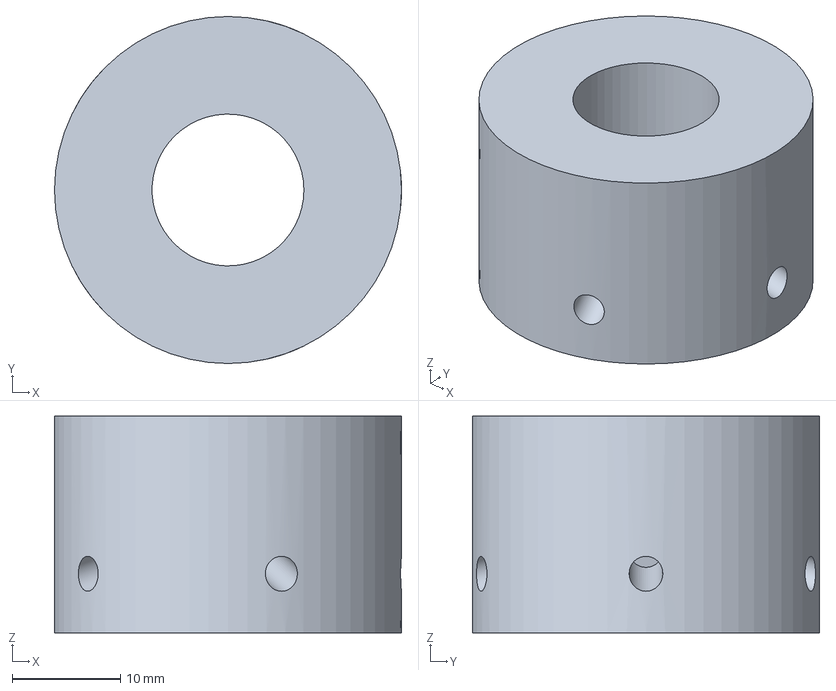
[picture p23: CAD file, 2026-10-24]
cad/step/pole-hub.step
32.0 x 32.0 x 20.0 mm
