https-shubhamsahu/surang-sutra-vishwakarma/cad/stl/puck-shell-lid.stl

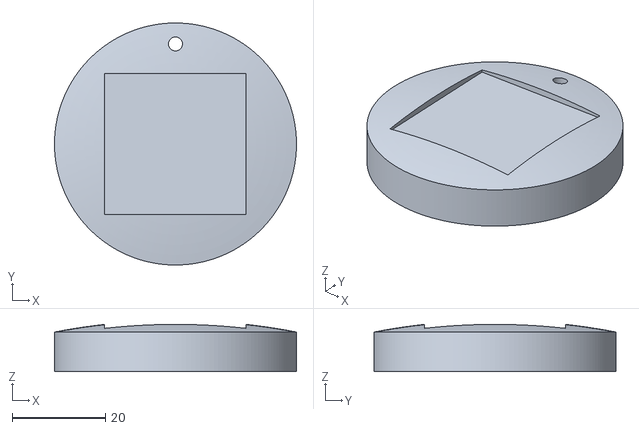
[picture p24: CAD file, 2026-10-24]
cad/stl/puck-shell-lid.stl
52.0 x 52.0 x 10.2
