https-shubhamsahu/surang-sutra-vishwakarma/cad/mesh/puck.obj

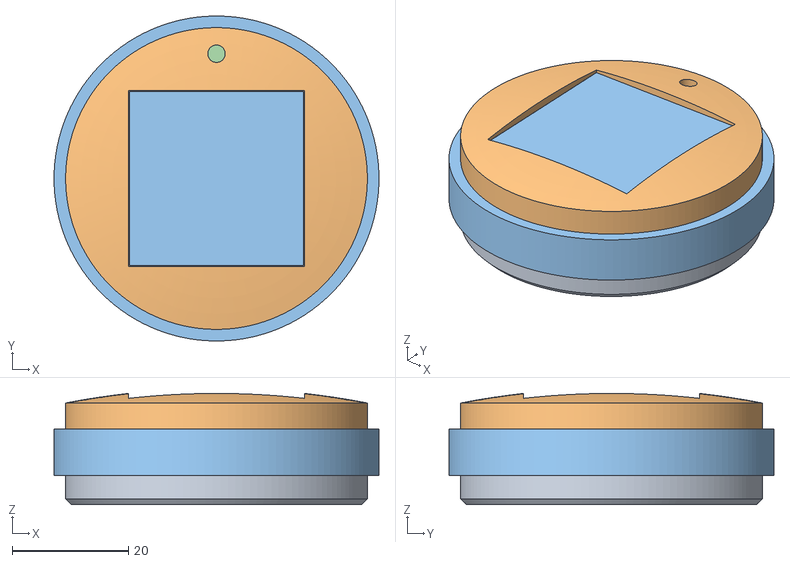
[picture p26: CAD file, 2026-10-24]
cad/mesh/puck.obj
56.0 x 56.0 x 19.2
Puck_Shell_Base
Puck_Shell_Lid
Puck_Bumper_TPU
Puck_PCB
Puck_LiPo_1S_400
Puck_ESP32C3_MINI1
Puck_RFM95W_868
Puck_Antenna_Stub
Puck_ChargePads
Puck_Passives_LED_Hall
Puck_AprilTag
