https-shubhamsahu/surang-sutra-vishwakarma/cad/step/cage.step

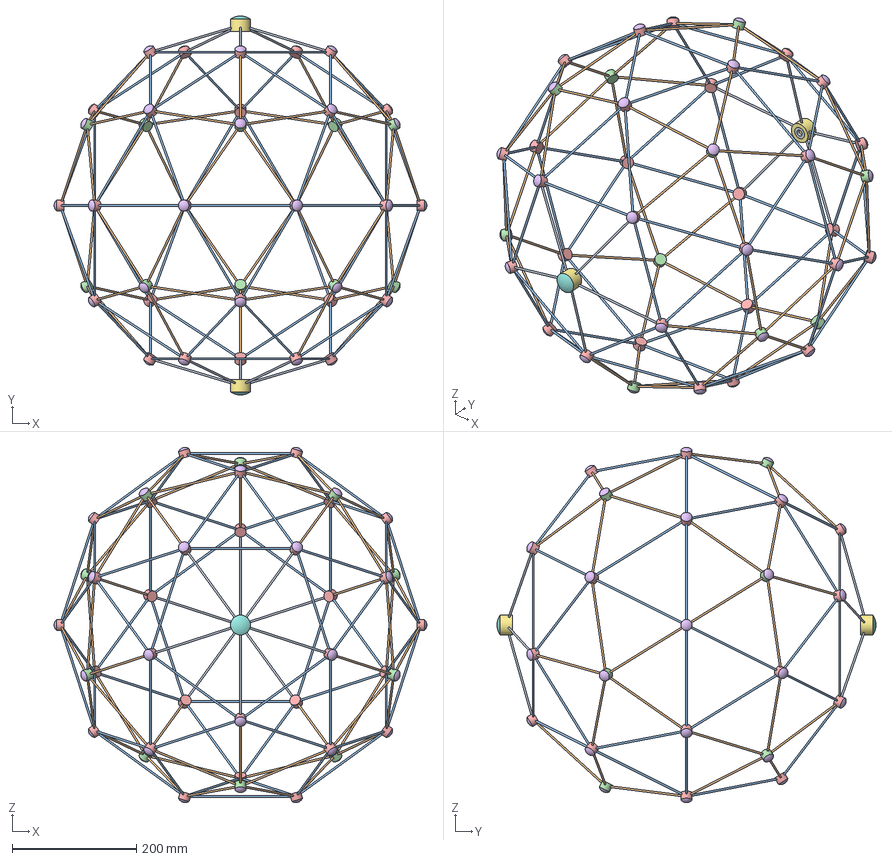
[picture p27: CAD file, 2026-10-24]
cad/step/cage.step
600.0 x 610.0 x 571.8 mm
Strut_000 x 2
Strut_001 x 2
Strut_002 x 2
Strut_003 x 2
Strut_004 x 2
Strut_005 x 2
Strut_006 x 2
Strut_007 x 2
Strut_008 x 2
Strut_009 x 2
Strut_010 x 2
Strut_011 x 2
Strut_012 x 2
Strut_013 x 2
Strut_014 x 2
Strut_015 x 2
Strut_016 x 2
Strut_017 x 2
Strut_018 x 2
Strut_019 x 2
Strut_020 x 2
Strut_021 x 2
Strut_022 x 2
Strut_023 x 2
Strut_024 x 2
Strut_025 x 2
Strut_026 x 2
Strut_027 x 2
Strut_028 x 2
Strut_029 x 2
Strut_030 x 2
Strut_031 x 2
Strut_032 x 2
Strut_033 x 2
Strut_034 x 2
Strut_035 x 2
Strut_036 x 2
Strut_037 x 2
Strut_038 x 2
Strut_039 x 2
Strut_040 x 2
Strut_041 x 2
Strut_042 x 2
Strut_043 x 2
Strut_044 x 2
Strut_045 x 2
Strut_046 x 2
Strut_047 x 2
Strut_048 x 2
Strut_049 x 2
Strut_050 x 2
Strut_051 x 2
Strut_052 x 2
Strut_053 x 2
Strut_054 x 2
Strut_055 x 2
Strut_056 x 2
Strut_057 x 2
Strut_058 x 2
Strut_059 x 2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
