https-shubhamsahu/surang-sutra-vishwakarma/cad/stl/puck-bumper-tpu.stl

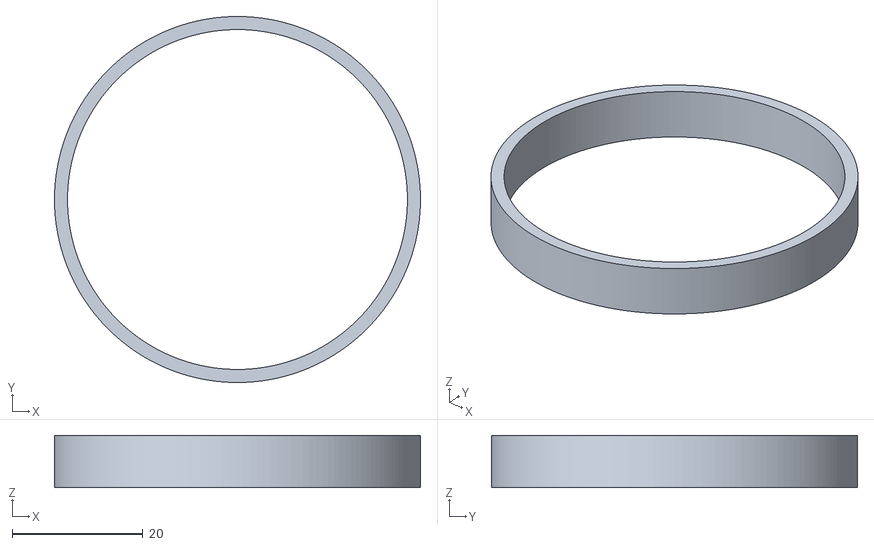
[picture p28: CAD file, 2026-10-24]
cad/stl/puck-bumper-tpu.stl
56.0 x 56.0 x 8.00
