https-shubhamsahu/surang-sutra-vishwakarma/cad/step/cage-hub-v5.step

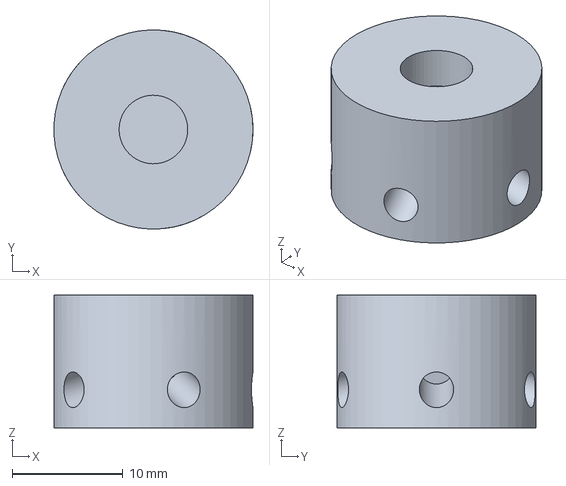
[picture p29: CAD file, 2026-10-24]
cad/step/cage-hub-v5.step
18.0 x 18.0 x 12.0 mm
