https-shubhamsahu/surang-sutra-vishwakarma/cad/stl/tpu-cap-hub.stl

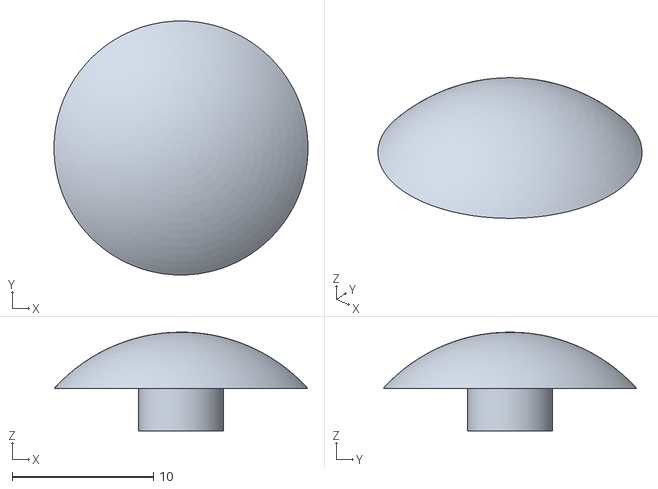
[picture p30: CAD file, 2026-10-24]
cad/stl/tpu-cap-hub.stl
18.0 x 18.0 x 7.00
