https-shubhamsahu/surang-sutra-vishwakarma/cad/stl/puck-shell-base.stl

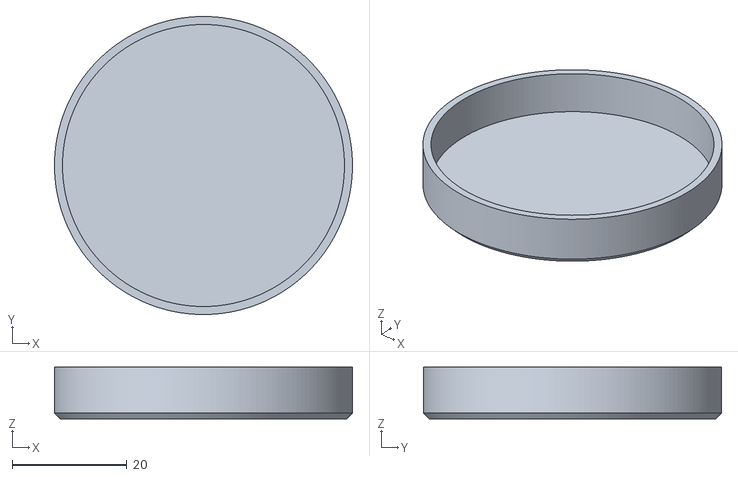
[picture p32: CAD file, 2026-10-24]
cad/stl/puck-shell-base.stl
52.0 x 52.0 x 9.00
