https-shubhamsahu/surang-sutra-vishwakarma/cad/step/frame.step

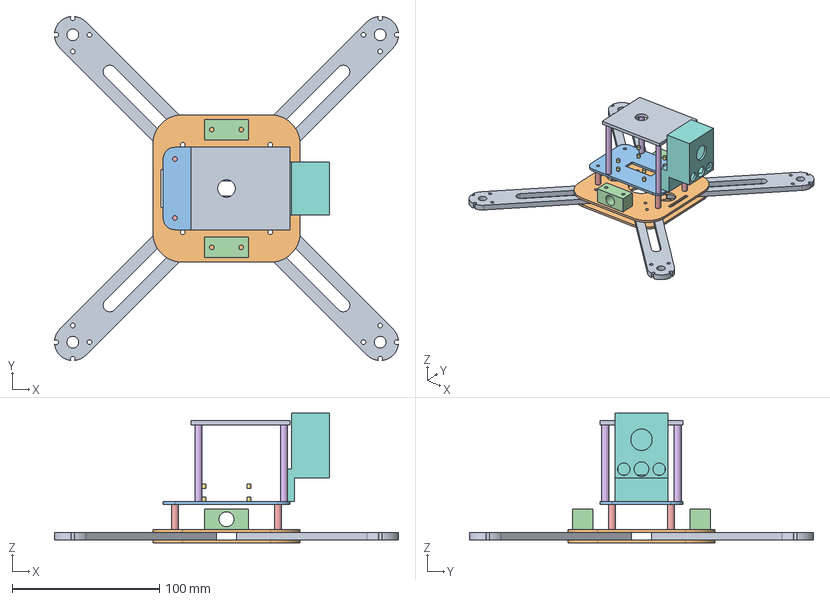
[picture p33: CAD file, 2026-10-24]
cad/step/frame.step
233.5 x 233.5 x 88.0 mm
Arm x 4
Plate_Sandwich x 2
Plate_Deck
AxleClamp x 2
Standoffs_Deck_M3
Standoffs_Stack_Posts
Nose_Bracket
LiDAR_Mast
