https-shubhamsahu/surang-sutra-vishwakarma/cad/stl/tpu-cap-pole.stl

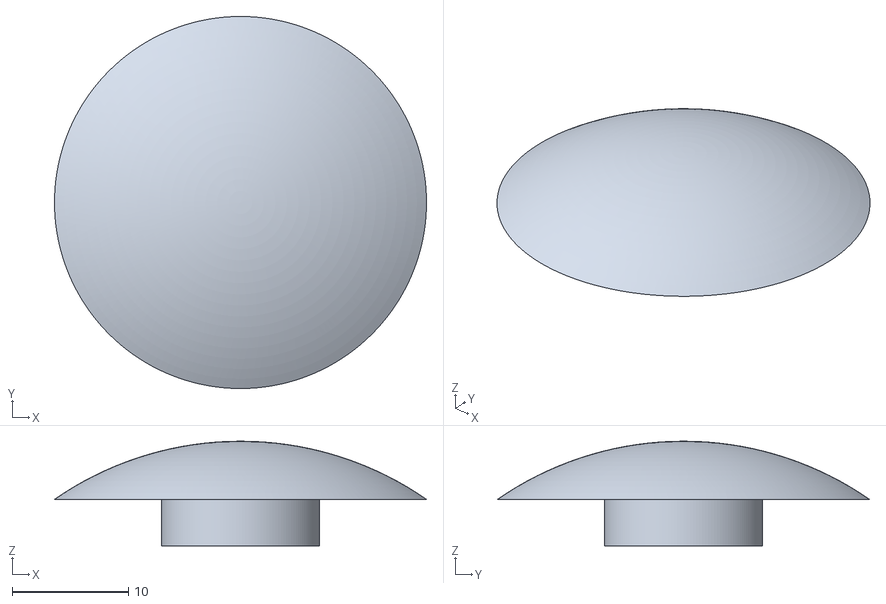
[picture p34: CAD file, 2026-10-24]
cad/stl/tpu-cap-pole.stl
32.0 x 32.0 x 9.00
