https-shubhamsahu/surang-sutra-vishwakarma/cad/stl/cage-hub-m6.stl

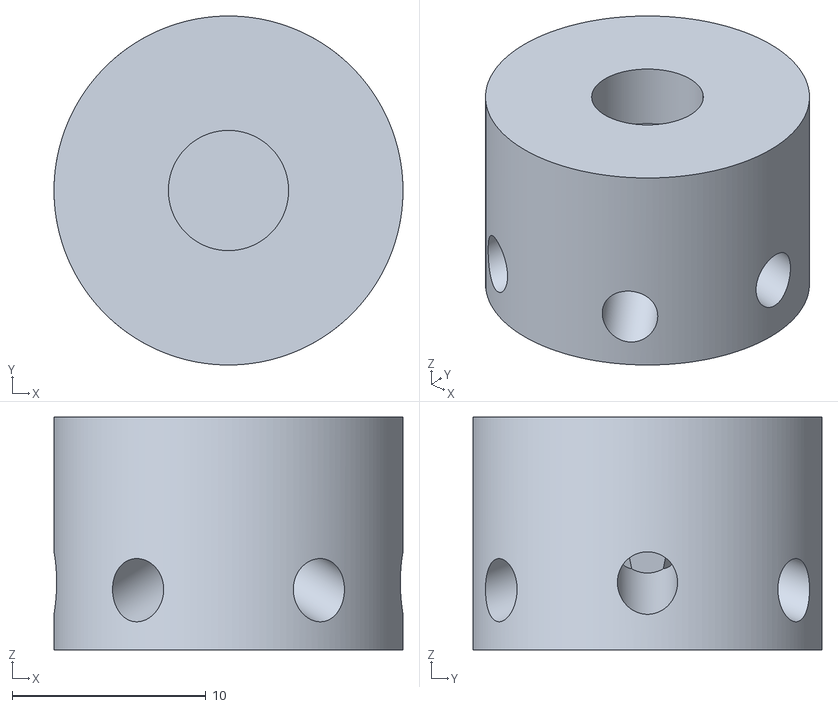
[picture p35: CAD file, 2026-10-24]
cad/stl/cage-hub-m6.stl
18.0 x 18.0 x 12.0
