https-shubhamsahu/surang-sutra-vishwakarma/cad/step/cassette.step

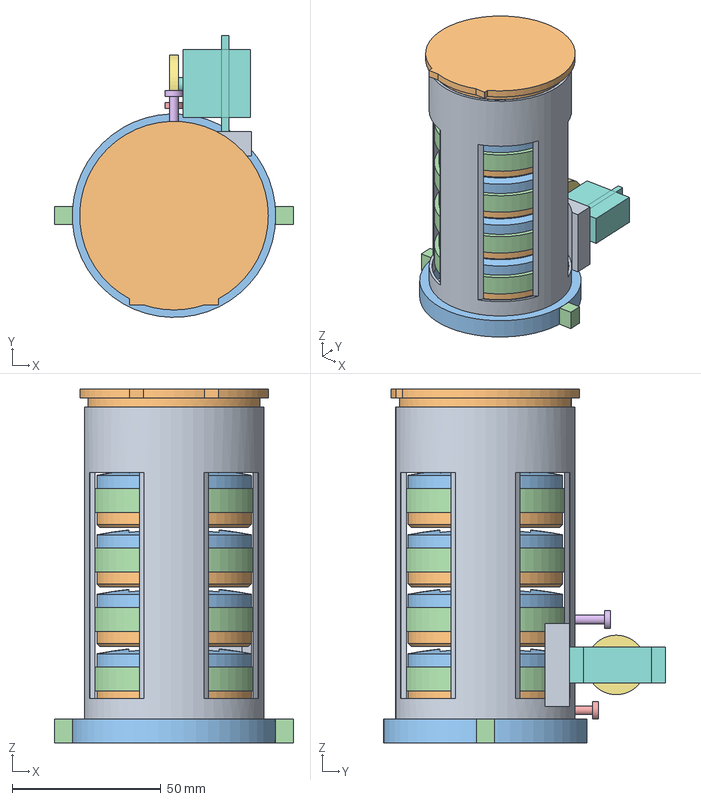
[picture p36: CAD file, 2026-10-24]
cad/step/cassette.step
80.4 x 94.7 x 119.0 mm
Cassette_Tube
Cassette_TopCap
BreakBeam_Collar
BreakBeam_IR_Pair
Pin_Release
Pin_Capture
Escapement_Cam
Servo_MG90S
Servo_Bracket
Puck_Shell_Base x 5
Puck_Shell_Lid x 5
Puck_Bumper_TPU x 5
Puck_PCB x 5
Puck_LiPo_1S_400 x 5
Puck_ESP32C3_MINI1 x 5
Puck_RFM95W_868 x 5
Puck_Antenna_Stub x 5
Puck_ChargePads x 5
Puck_Passives_LED_Hall x 5
