https-shubhamsahu/surang-sutra-vishwakarma/(list of files, cad)

Other CAD files:
cad/step/cage-hub.step
cad/stl/cage-hub-v5.stl
cad/stl/pole-hub.stl
