https-shubhamsahu/surang-sutra-vishwakarma/electronics/exports/sutra-puck.pdf

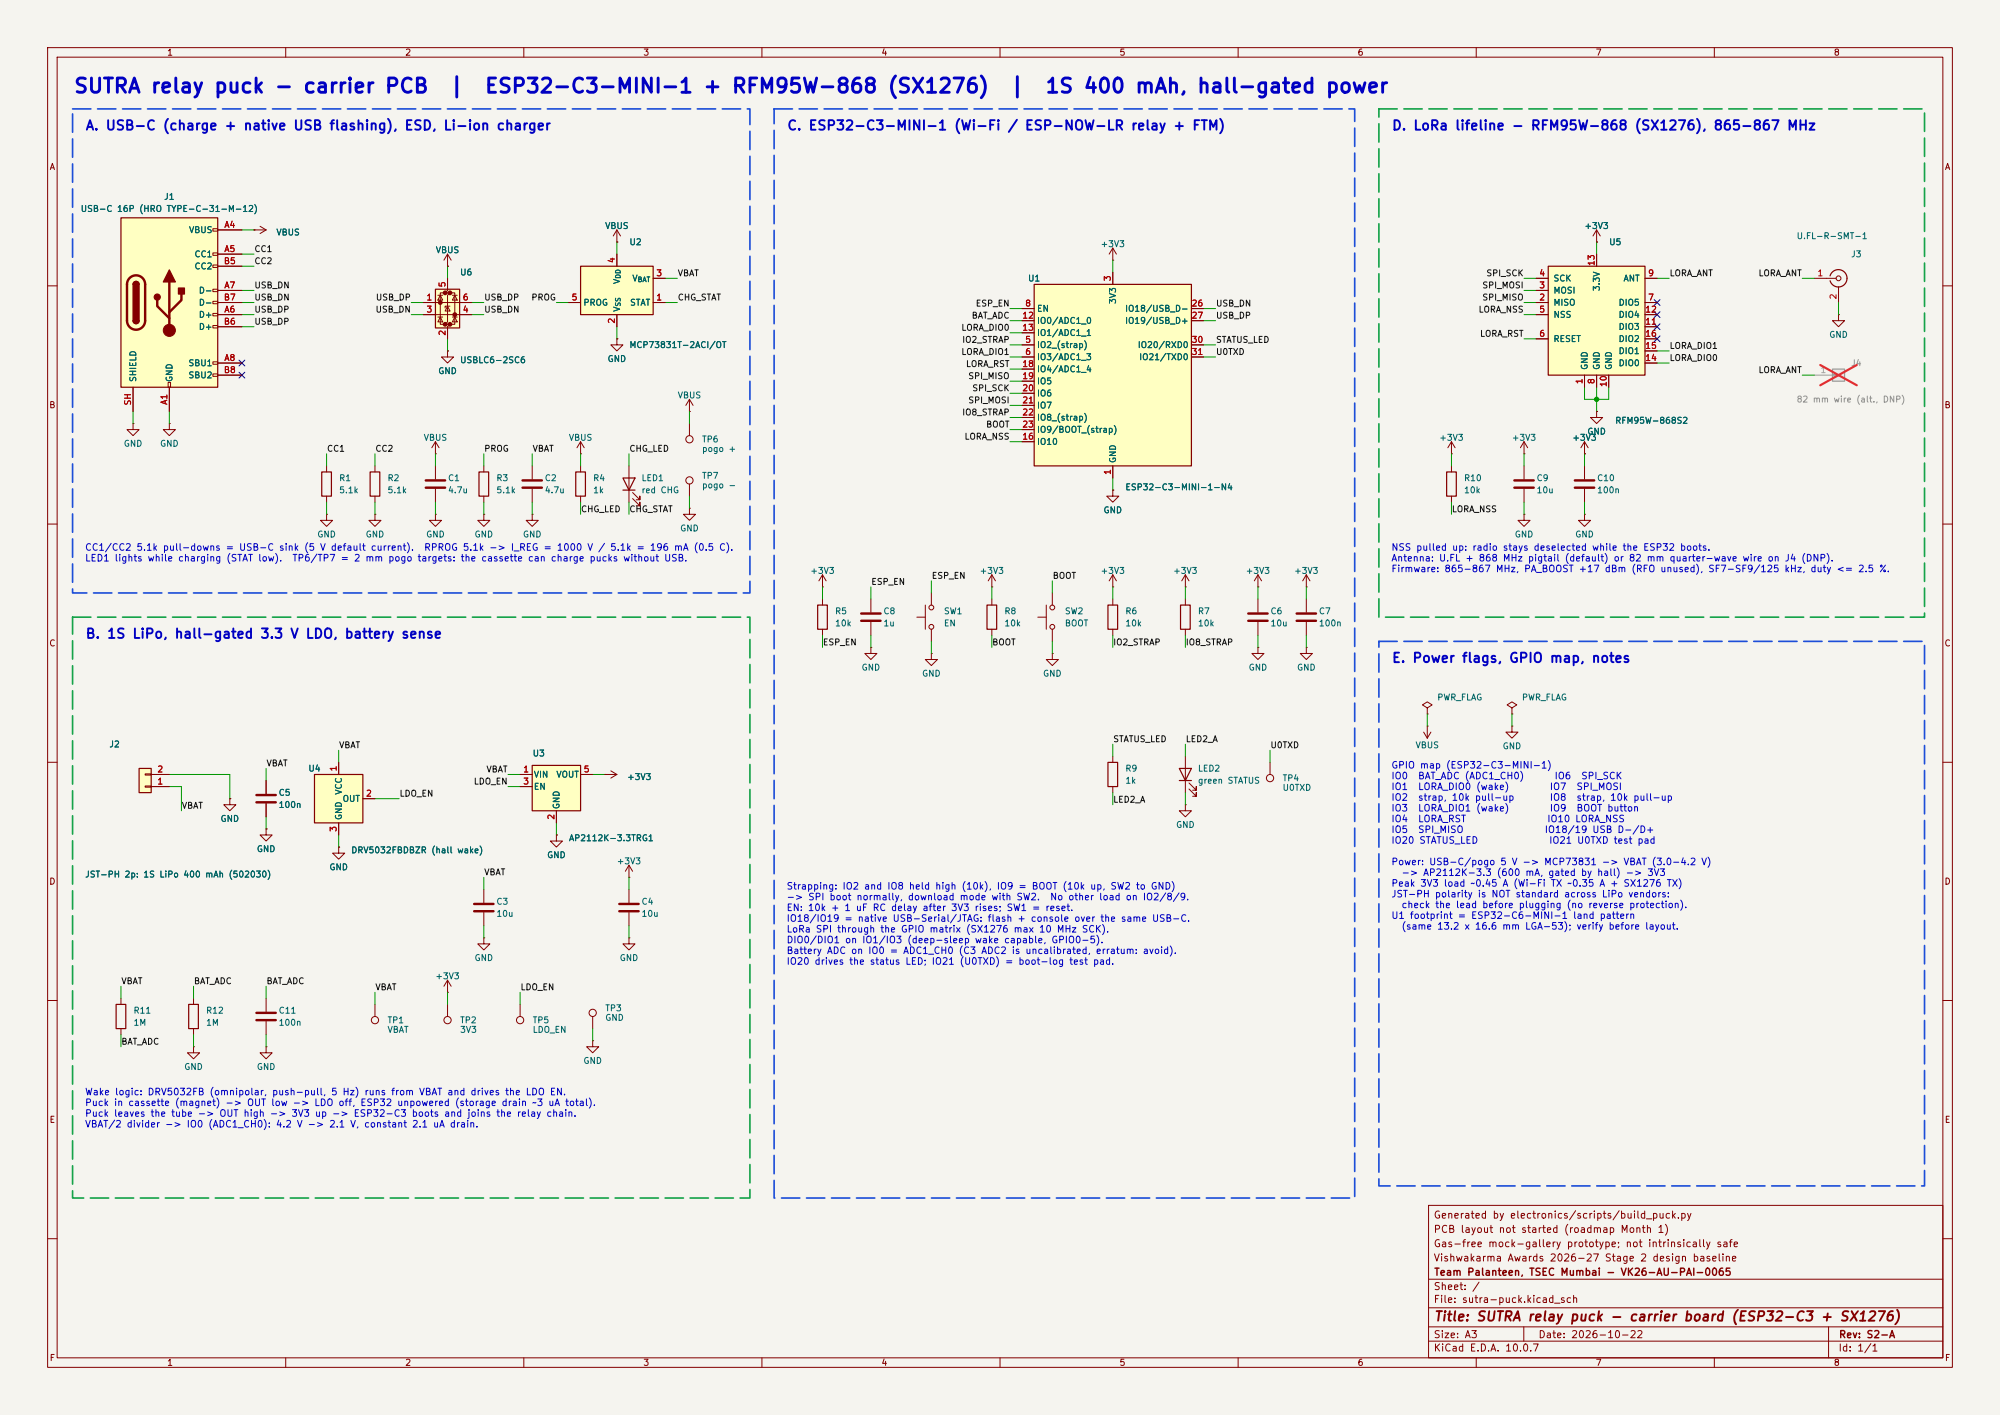
[picture p38: page 1]

SUTRA relay puck - carrier PCB | ESP32-C3-MINI-1 + RFM95W-868 (SX1276) | 1S 400 mAh, hall-gated power

A. USB-C (charge + native USB flashing), ESD, Li-ion charger

C. ESP32-C3-MINI-1 (Wi-Fi / ESP-NOW-LR relay + FTM)

J1 USB-C 16P (HRO TYPE-C-31-M-12) GND A1

82 mm wire (alt., DNP) GND

B. 1S LiPo, hall-gated 3.3 V LDO, battery sense

E. Power flags, GPIO map, notes

JST-PH 2p: 1S LiPo 400 mAh (502030) 1

Strapping: IO2 and IO8 held high (10k), IO9 = BOOT (10k up, SW2 to GND) -> SPI boot normally, download mode with SW2. No other load on IO2/8/9. EN: 10k + 1 uF RC delay after 3V3 rises; SW1 = reset.

IO18/IO19 = native USB-Serial/JTAG: flash + console over the same USB-C. LoRa SPI through the GPIO matrix (SX1276 max 10 MHz SCK).

(same 13.2 x 16.6 mm LGA-53); verify before layout.

DIO0/DIO1 on IO1/IO3 (deep-sleep wake capable, GPIO0-5).
Battery ADC on IO0 = ADC1_CH0 (C3 ADC2 is uncalibrated, erratum: avoid).
IO20 drives the status LED; IO21 (U0TXD) = boot-log test pad.

Generated by electronics/scripts/build_puck.py
PCB layout not started (roadmap Month 1)
Gas-free mock-gallery prototype; not intrinsically safe
Vishwakarma Awards 2026-27 Stage 2 design baseline
Team Palanteen, TSEC Mumbai - VK26-AU-PAI-0065
Sheet: /
File: sutra-puck.kicad_sch
Title: SUTRA relay puck - carrier board (ESP32-C3 + SX1276)

Size: A3 | Rev: S2-A | F Date: 2026-10-22
KiCad E.D.A. 10.0.7 | Id: 1/1
