https-shubhamsahu/surang-sutra-vishwakarma/electronics/kicad/surang-sutra/surang-avionics.kicad_sch

## KiCad design electronics/kicad/surang-sutra/surang-avionics.kicad_sch (2026-10-21)

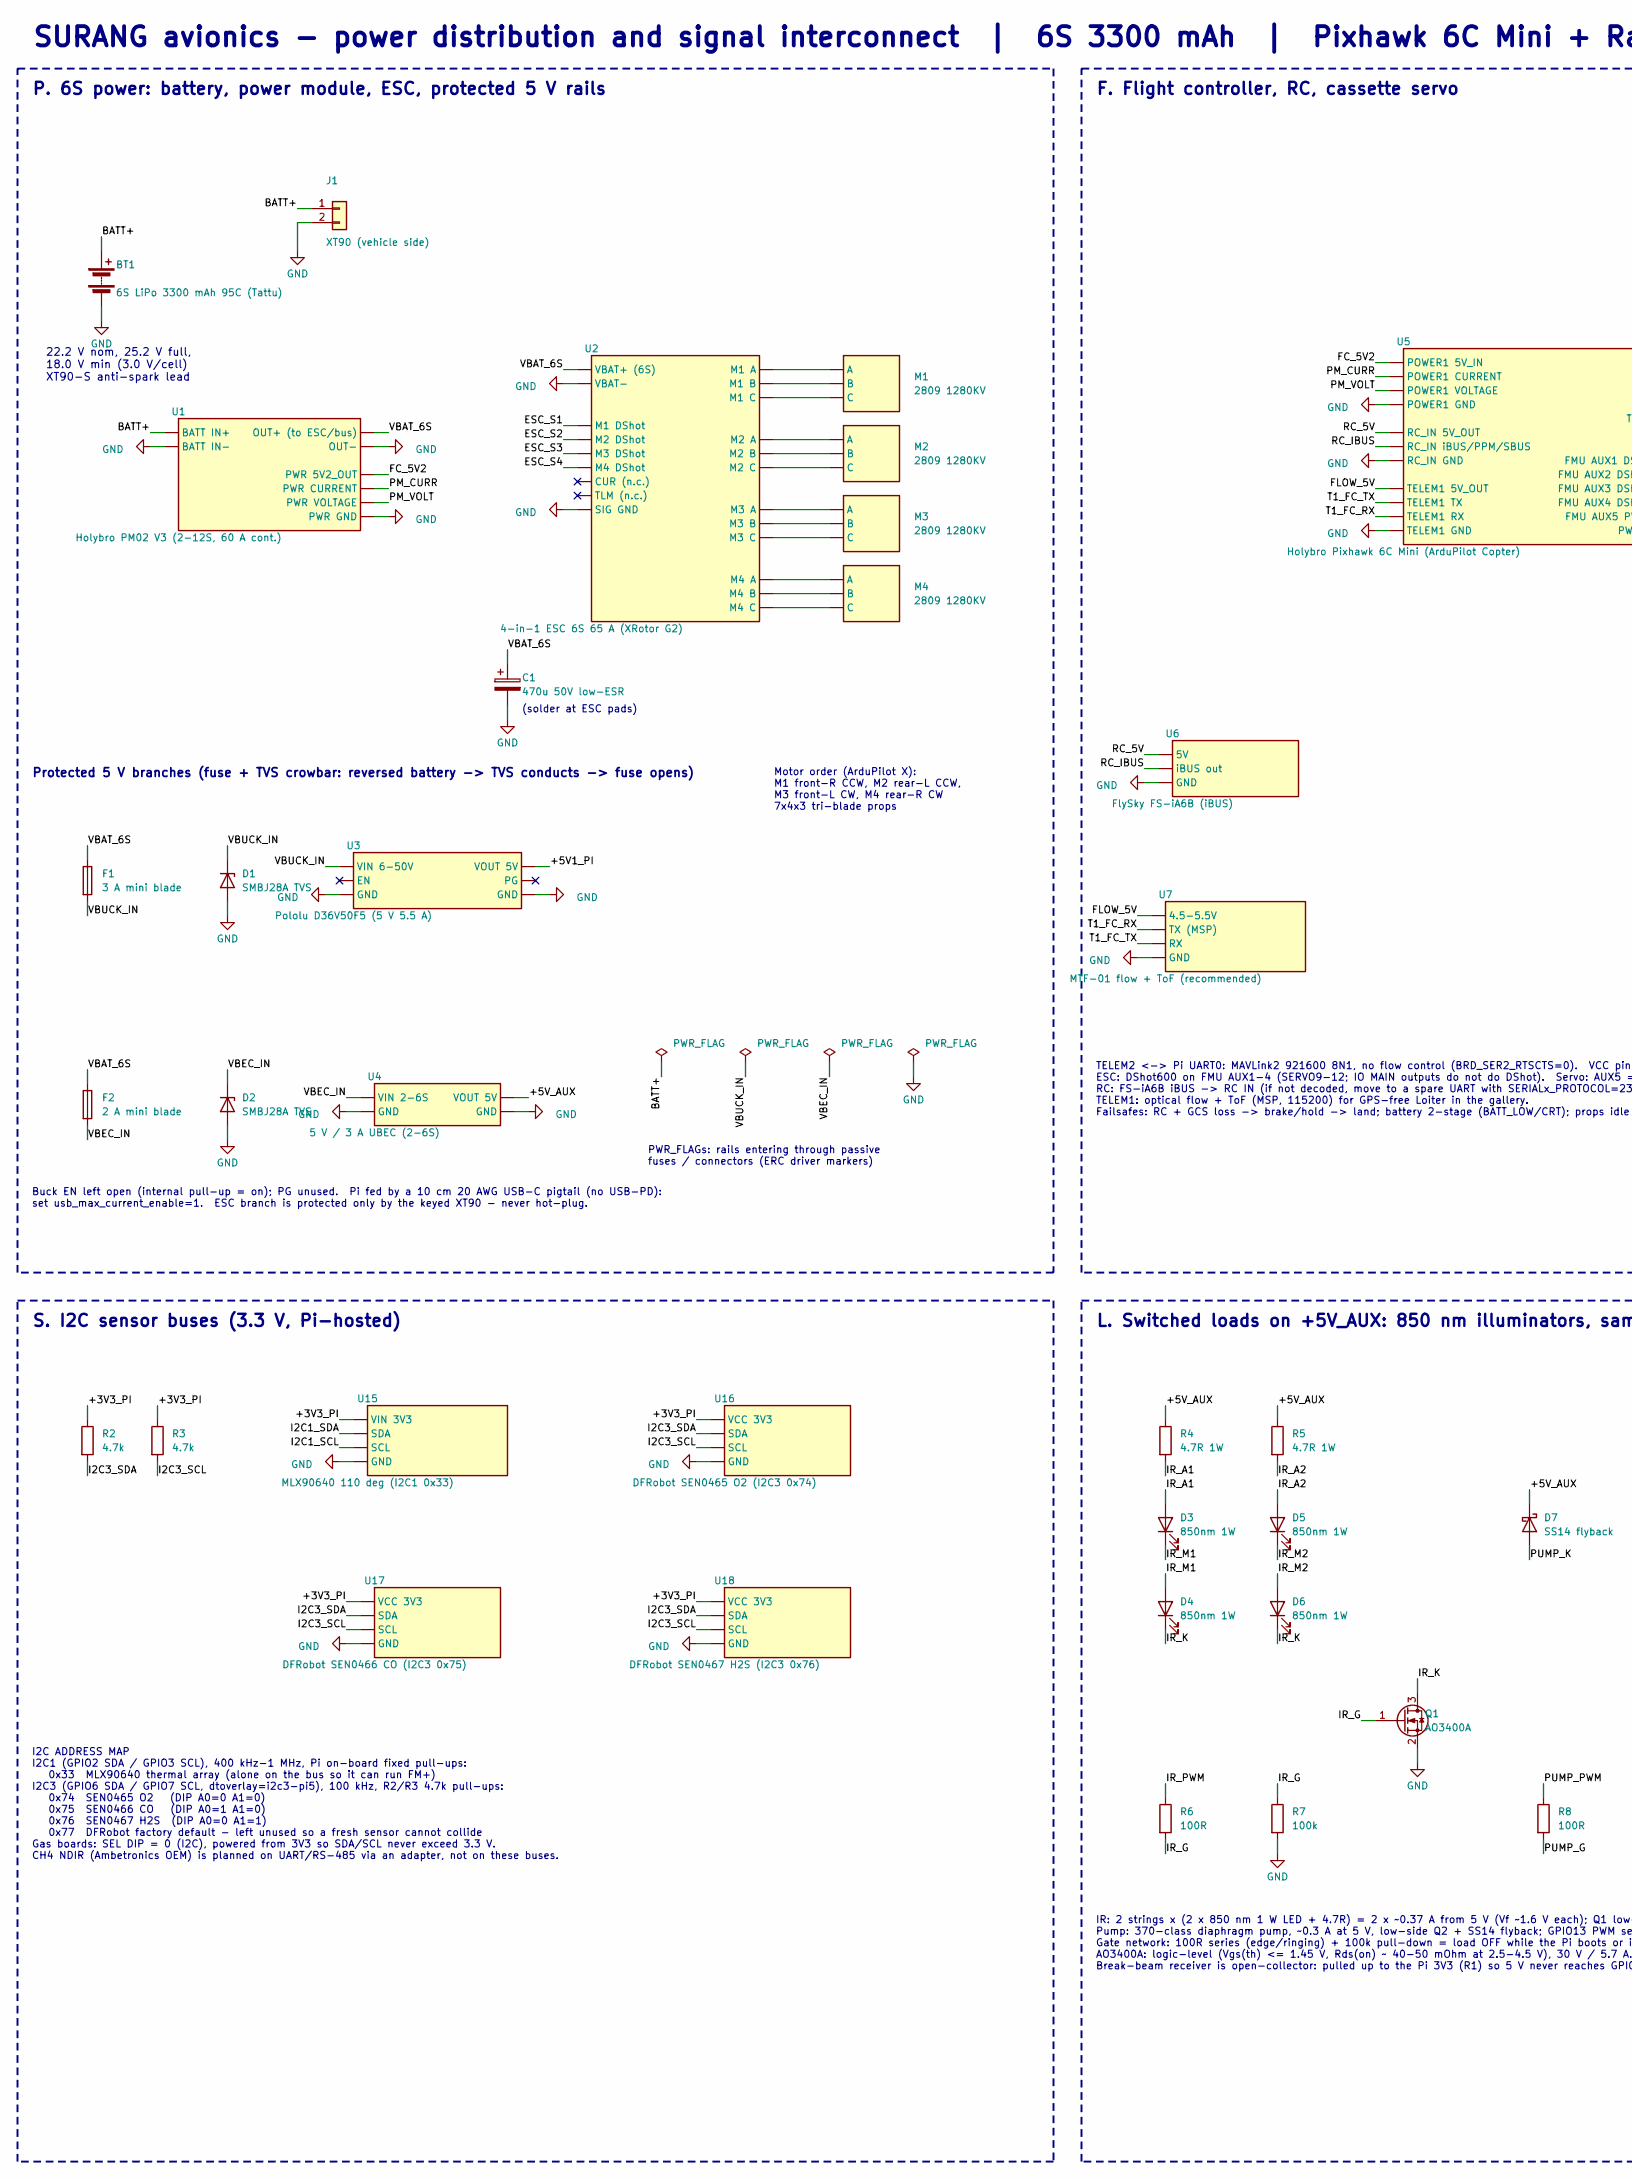
[picture p39: schematic surang-avionics.kicad_sch, part in row 1, column 1]

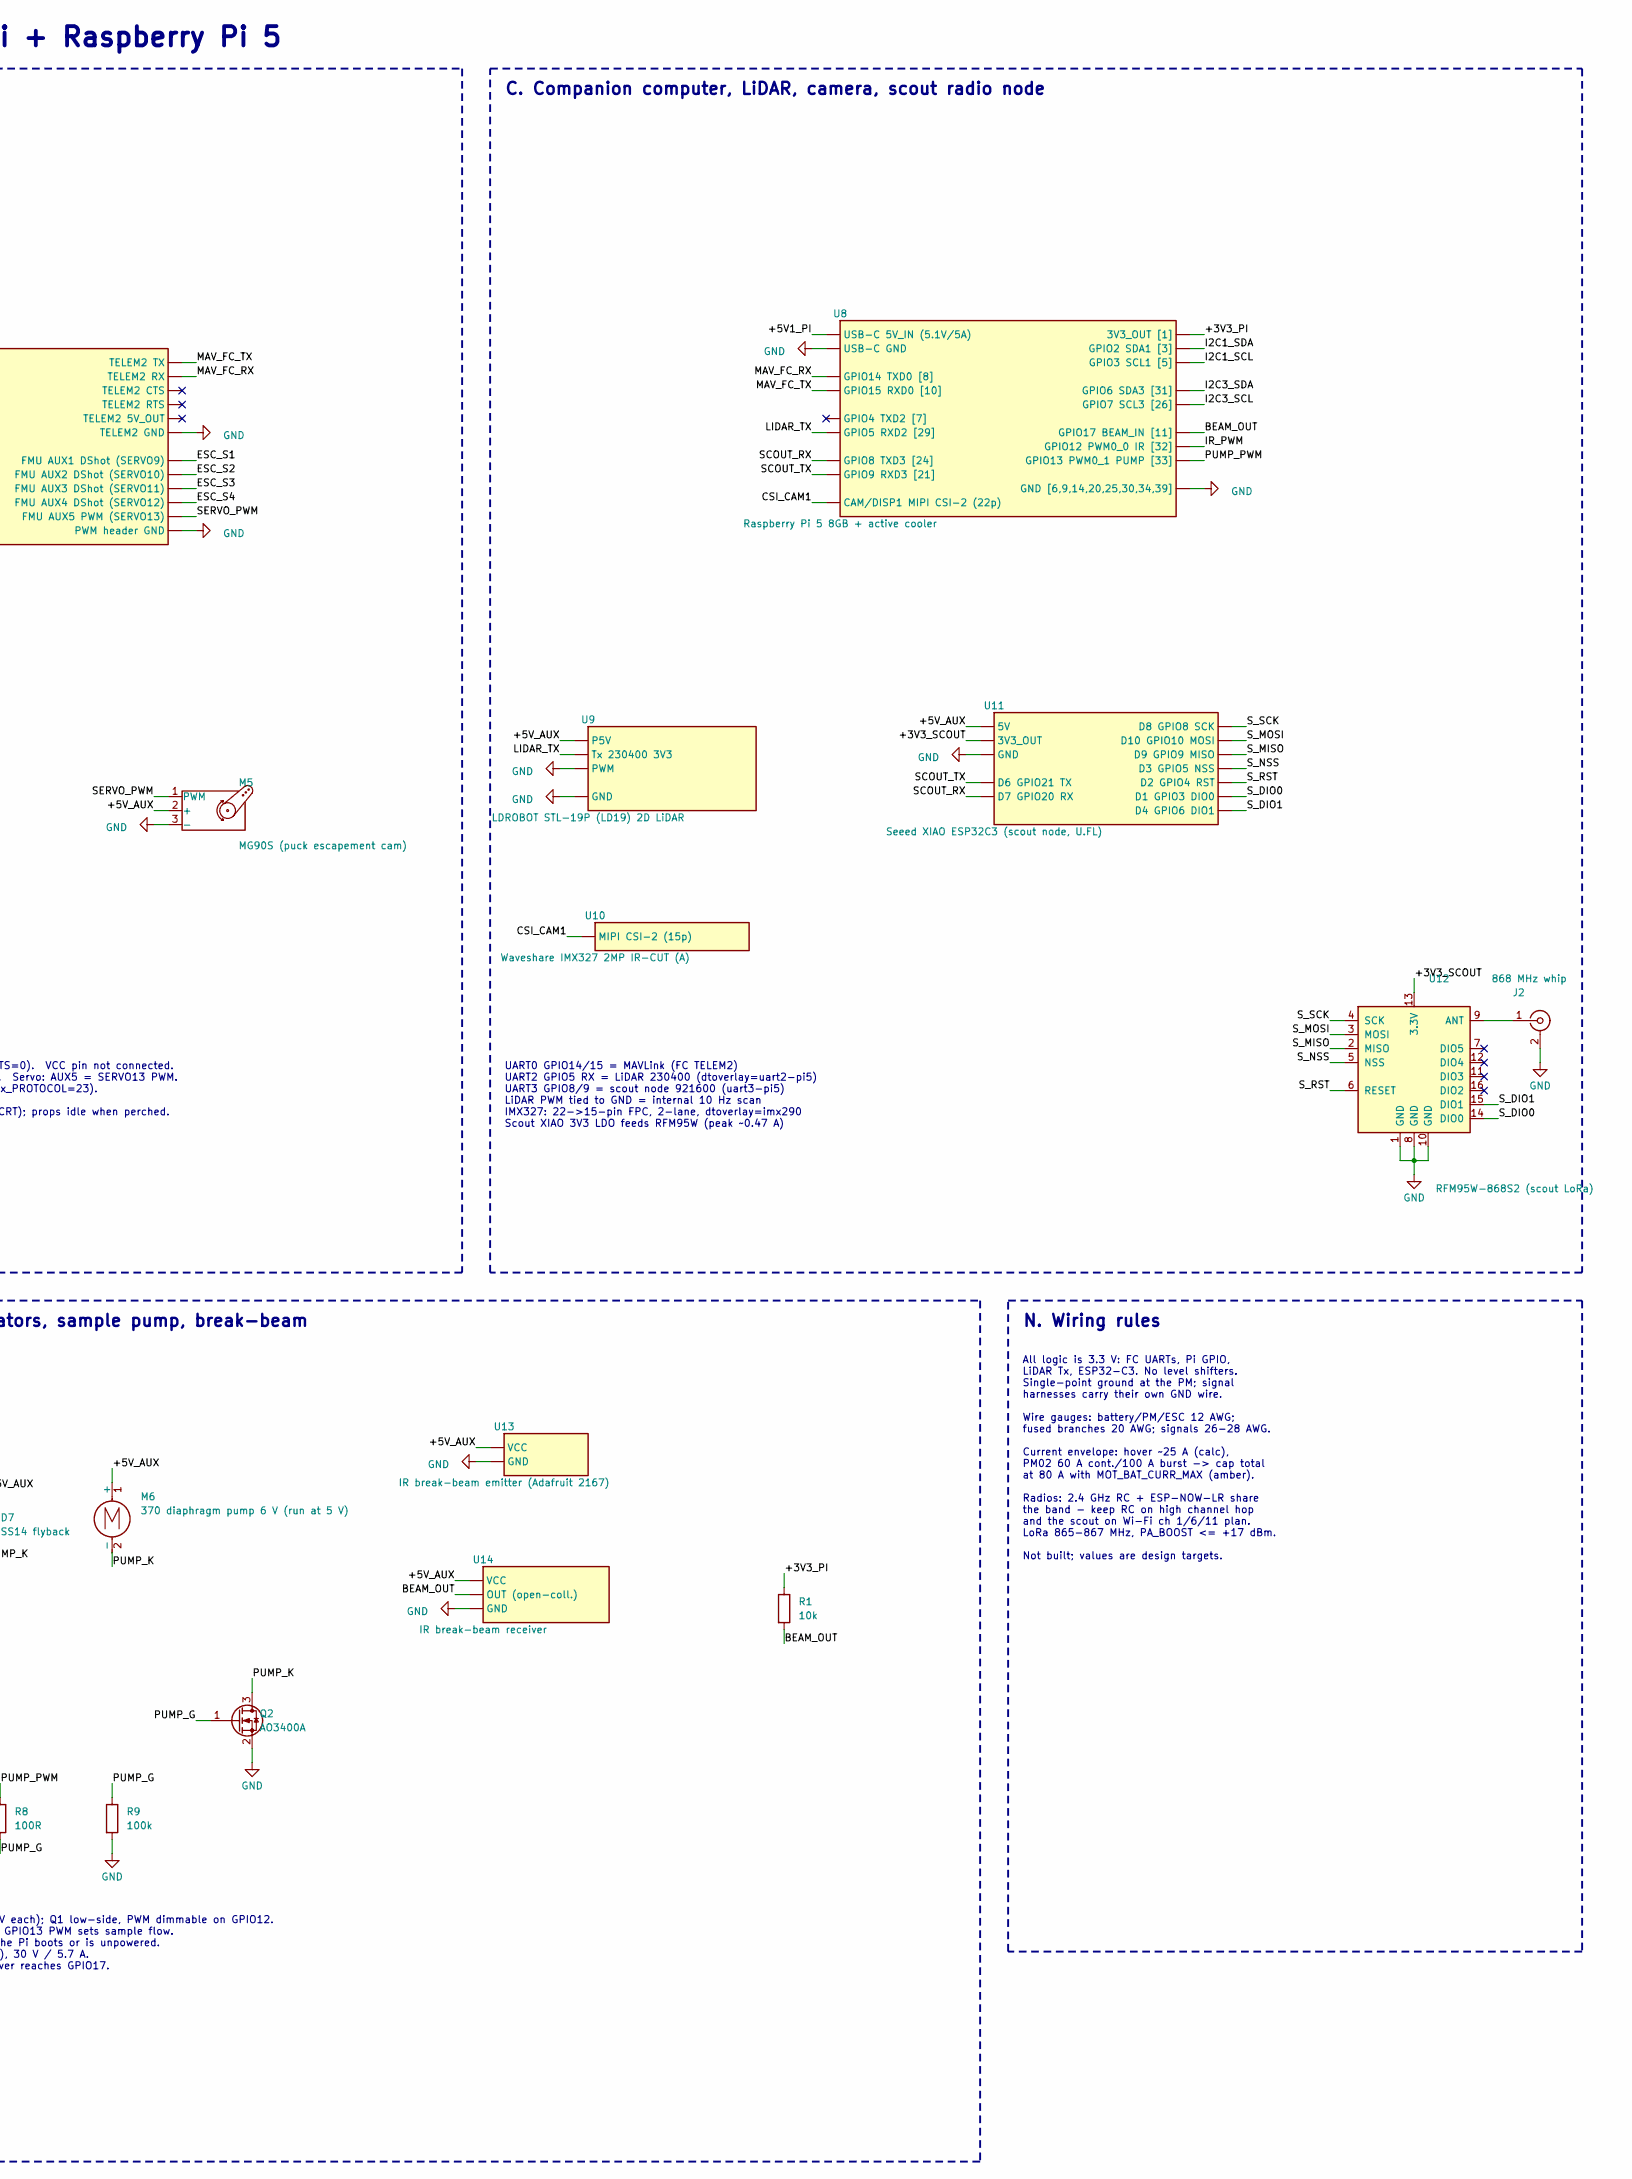
[picture p40: schematic surang-avionics.kicad_sch, part in row 1, column 2]

Parts:
BT1: 6S LiPo 3300 mAh 95C (Tattu); MPN TAS33006S95X9
C1: 470u 50V low-ESR; CP_Radial_D10.0mm_P5.00mm; MPN Panasonic EEU-FR1H471
D1, D2: SMBJ28A TVS; D_SMB; MPN SMBJ28A
D3, D4, D5, D6: 850nm 1W; LED_1W_3W_R8
D7: SS14 flyback; D_SMA; MPN SS14
F1: 3 A mini blade; Fuse_Blade_Mini_directSolder; MPN Littelfuse 0297003
F2: 2 A mini blade; Fuse_Blade_Mini_directSolder; MPN Littelfuse 0297002
J1: XT90 (vehicle side); AMASS_XT90PW-M_1x02_P10.90mm_Horizontal; MPN AMASS XT90H
J2: 868 MHz whip; U.FL_Hirose_U.FL-R-SMT-1_Vertical
M1, M2, M3, M4: 2809 1280KV; MPN GEPRC SPEEDX2 2809 1280KV
M5: MG90S (puck escapement cam); MPN MG90S
M6: 370 diaphragm pump 6 V (run at 5 V); MPN 370 micro air pump
Q1, Q2: AO3400A; SOT-23; MPN AO3400A
R1: 10k; R_0603_1608Metric
R2, R3: 4.7k; R_0603_1608Metric
R4, R5: 4.7R 1W; R_2512_6332Metric; MPN 2512 4.7R 1W
R6, R8: 100R; R_0603_1608Metric
R7, R9: 100k; R_0603_1608Metric
U1: Holybro PM02 V3 (2-12S, 60 A cont.); MPN Holybro PM02 V3
U2: 4-in-1 ESC 6S 65 A (XRotor G2); MPN Hobbywing XRotor G2 65A 4in1
U3: Pololu D36V50F5 (5 V 5.5 A); MPN Pololu #4091
U4: 5 V / 3 A UBEC (2-6S); MPN ReadytoSky 2-6S 5V3A UBEC
U5: Holybro Pixhawk 6C Mini (ArduPilot Copter); MPN Holybro Pixhawk 6C Mini
U6: FlySky FS-iA6B (iBUS); MPN FlySky FS-iA6B
U7: MTF-01 flow + ToF (recommended); MPN MicoAir MTF-01
U8: Raspberry Pi 5 8GB + active cooler; MPN SC1112
U9: LDROBOT STL-19P (LD19) 2D LiDAR; MPN STL-19P / D500 kit
U10: Waveshare IMX327 2MP IR-CUT (A); MPN Waveshare 23752
U11: Seeed XIAO ESP32C3 (scout node, U.FL); MPN Seeed 113991054
U12: RFM95W-868S2 (scout LoRa); HOPERF_RFM9XW_SMD; MPN RFM95W-868S2
U13: IR break-beam emitter (Adafruit 2167); MPN Adafruit 2167
U14: IR break-beam receiver; MPN Adafruit 2167
U15: MLX90640 110 deg (I2C1 0x33); MPN 7Semi MLX90640 110deg
U16: DFRobot SEN0465 O2 (I2C3 0x74); MPN DFRobot SEN0465
U17: DFRobot SEN0466 CO (I2C3 0x75); MPN DFRobot SEN0466
U18: DFRobot SEN0467 H2S (I2C3 0x76); MPN DFRobot SEN0467

Connections:
+3V3_PI: R1.1, R2.1, R3.1, U8.1 (3V3_OUT [1]), U15.VIN (VIN 3V3), U16.VCC (VCC 3V3), U17.VCC (VCC 3V3), U18.VCC (VCC 3V3)
+3V3_SCOUT: U11.3V3 (3V3_OUT), U12.13 (3.3V)
+5V1_PI: U3.VOUT (VOUT 5V), U8.USBC.VBUS (USB-C 5V_IN (5.1V/5A))
+5V_AUX: D7.1 (K), M5.2 (+), M6.1 (+), R4.1, R5.1, U4.VOUT (VOUT 5V), U9.P5V, U11.5V, U13.VCC, U14.VCC
BATT+: BT1.1 (+), J1.1, U1.IN+ (BATT IN+)
BEAM_OUT: R1.2, U8.11 (GPIO17 BEAM_IN [11]), U14.OUT (OUT (open-coll.))
CSI_CAM1: U8.CAM1 (CAM/DISP1 MIPI CSI-2 (22p)), U10.CSI
ESC_S1: U2.S1 (M1 DShot), U5.AUX.1 (FMU AUX1 DShot (SERVO9))
ESC_S2: U2.S2 (M2 DShot), U5.AUX.2 (FMU AUX2 DShot (SERVO10))
ESC_S3: U2.S3 (M3 DShot), U5.AUX.3 (FMU AUX3 DShot (SERVO11))
ESC_S4: U2.S4 (M4 DShot), U5.AUX.4 (FMU AUX4 DShot (SERVO12))
FC_5V2: U1.PWR.1 (PWR 5V2_OUT), U5.POWER1.1 (POWER1 5V_IN)
FLOW_5V: U5.TELEM1.1 (TELEM1 5V_OUT), U7.5V (4.5-5.5V)
GND: BT1.2 (-), C1.2, D1.2 (A), D2.2 (A), J1.2, J2.2 (Ext), M5.3 (-), Q1.2 (S), Q2.2 (S), R7.2, R9.2, U1.IN- (BATT IN-), U1.OUT-, U1.PWR.5 (PWR GND), U2.SGND (SIG GND), U2.VBAT-, U3.GND1 (GND), U3.GND2 (GND), U4.GND1 (GND), U4.GND2 (GND), U5.AUX.GND (PWM header GND), U5.POWER1.5 (POWER1 GND), U5.RC.3 (RC_IN GND), U5.TELEM1.6 (TELEM1 GND), U5.TELEM2.6 (TELEM2 GND), U6.GND, U7.GND, U8.6 (GND [6,9,14,20,25,30,34,39]), U8.USBC.GND (USB-C GND), U9.GND, U9.PWM, U11.GND, U12.1 (GND), U12.8 (GND), U12.10 (GND), U13.GND, U14.GND, U15.GND, U16.GND, U17.GND, U18.GND
I2C1_SCL: U8.5 (GPIO3 SCL1 [5]), U15.SCL
I2C1_SDA: U8.3 (GPIO2 SDA1 [3]), U15.SDA
I2C3_SCL: R3.2, U8.26 (GPIO7 SCL3 [26]), U16.SCL, U17.SCL, U18.SCL
I2C3_SDA: R2.2, U8.31 (GPIO6 SDA3 [31]), U16.SDA, U17.SDA, U18.SDA
IR_A1: D3.2 (A), R4.2
IR_A2: D5.2 (A), R5.2
IR_G: Q1.1 (G), R6.2, R7.1
IR_K: D4.1 (K), D6.1 (K), Q1.3 (D)
IR_M1: D3.1 (K), D4.2 (A)
IR_M2: D5.1 (K), D6.2 (A)
IR_PWM: R6.1, U8.32 (GPIO12 PWM0_0 IR [32])
LIDAR_TX: U8.29 (GPIO5 RXD2 [29]), U9.TX (Tx 230400 3V3)
MAV_FC_RX: U5.TELEM2.3 (TELEM2 RX), U8.8 (GPIO14 TXD0 [8])
MAV_FC_TX: U5.TELEM2.2 (TELEM2 TX), U8.10 (GPIO15 RXD0 [10])
unnamed: J2.1 (In), U12.9 (ANT)
unnamed: M1.A, U2.M1A (M1 A)
unnamed: M1.B, U2.M1B (M1 B)
unnamed: M1.C, U2.M1C (M1 C)
unnamed: M2.A, U2.M2A (M2 A)
unnamed: M2.B, U2.M2B (M2 B)
unnamed: M2.C, U2.M2C (M2 C)
unnamed: M3.A, U2.M3A (M3 A)
unnamed: M3.B, U2.M3B (M3 B)
unnamed: M3.C, U2.M3C (M3 C)
unnamed: M4.A, U2.M4A (M4 A)
unnamed: M4.B, U2.M4B (M4 B)
unnamed: M4.C, U2.M4C (M4 C)
PM_CURR: U1.PWR.3 (PWR CURRENT), U5.POWER1.3 (POWER1 CURRENT)
PM_VOLT: U1.PWR.4 (PWR VOLTAGE), U5.POWER1.4 (POWER1 VOLTAGE)
PUMP_G: Q2.1 (G), R8.2, R9.1
PUMP_K: D7.2 (A), M6.2 (-), Q2.3 (D)
PUMP_PWM: R8.1, U8.33 (GPIO13 PWM0_1 PUMP [33])
RC_5V: U5.RC.1 (RC_IN 5V_OUT), U6.5V
RC_IBUS: U5.RC.2 (RC_IN iBUS/PPM/SBUS), U6.IBUS (iBUS out)
SCOUT_RX: U8.24 (GPIO8 TXD3 [24]), U11.D7 (D7 GPIO20 RX)
SCOUT_TX: U8.21 (GPIO9 RXD3 [21]), U11.D6 (D6 GPIO21 TX)
SERVO_PWM: M5.1 (PWM), U5.AUX.5 (FMU AUX5 PWM (SERVO13))
S_DIO0: U11.D1 (D1 GPIO3 DIO0), U12.14 (DIO0)
S_DIO1: U11.D4 (D4 GPIO6 DIO1), U12.15 (DIO1)
S_MISO: U11.D9 (D9 GPIO9 MISO), U12.2 (MISO)
S_MOSI: U11.D10 (D10 GPIO10 MOSI), U12.3 (MOSI)
S_NSS: U11.D3 (D3 GPIO5 NSS), U12.5 (NSS)
S_RST: U11.D2 (D2 GPIO4 RST), U12.6 (RESET)
S_SCK: U11.D8 (D8 GPIO8 SCK), U12.4 (SCK)
T1_FC_RX: U5.TELEM1.3 (TELEM1 RX), U7.TX (TX (MSP))
T1_FC_TX: U5.TELEM1.2 (TELEM1 TX), U7.RX
VBAT_6S: C1.1, F1.1, F2.1, U1.OUT+ (OUT+ (to ESC/bus)), U2.VBAT+ (VBAT+ (6S))
VBEC_IN: D2.1 (K), F2.2, U4.VIN (VIN 2-6S)
VBUCK_IN: D1.1 (K), F1.2, U3.VIN (VIN 6-50V)

Notes on the sheet:
SURANG avionics - power distribution and signal interconnect | 6S 3300 mAh | Pixhawk 6C Mini + Raspberry Pi 5
P. 6S power: battery, power module, ESC, protected 5 V rails
22.2 V nom, 25.2 V full, 18.0 V min (3.0 V/cell) XT90-S anti-spark lead
(solder at ESC pads)
Motor order (ArduPilot X): M1 front-R CCW, M2 rear-L CCW, M3 front-L CW, M4 rear-R CW 7x4x3 tri-blade props
Protected 5 V branches (fuse + TVS crowbar: reversed battery -> TVS conducts -> fuse opens)
PWR_FLAGs: rails entering through passive fuses / connectors (ERC driver markers)
Buck EN left open (internal pull-up = on); PG unused. Pi fed by a 10 cm 20 AWG USB-C pigtail (no USB-PD): set usb_max_current_enable=1. ESC branch is protected only by the keyed XT90 - never hot-plug.
F. Flight controller, RC, cassette servo
TELEM2 <-> Pi UART0: MAVLink2 921600 8N1, no flow control (BRD_SER2_RTSCTS=0). VCC pin not connected. ESC: DShot600 on FMU AUX1-4 (SERVO9-12; IO MAIN outputs do not do DShot). Servo: AUX5 = SERVO13 PWM. RC: FS-iA6B iBUS -> RC IN (if not decoded, move to a spare UART with SERIALx_PROTOCOL=23). TELEM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
C. Companion computer, LiDAR, camera, scout radio node
UART0 GPIO14/15 = MAVLink (FC TELEM2) UART2 GPIO5 RX = LiDAR 230400 (dtoverlay=uart2-pi5) UART3 GPIO8/9 = scout node 921600 (uart3-pi5) LiDAR PWM tied to GND = internal 10 Hz scan IMX327: 22->15-pin FPC, 2-lane, dtoverlay=imx290 Scout XIAO 3V3 LDO feeds RFM95W (peak ~0.47 A)
S. I2C sensor buses (3.3 V, Pi-hosted)
I2C ADDRESS MAP I2C1 (GPIO2 SDA / GPIO3 SCL), 400 kHz-1 MHz, Pi on-board fixed pull-ups: 0x33 MLX90640 thermal array (alone on the bus so it can run FM+) I2C3 (GPIO6 SDA / GPIO7 SCL, dtoverlay=i2c3-pi5), 100 kHz, R2/R3 4.7k pull-ups: 0x74 SEN0465 O2 (DIP A0=0 A1=0) 0x75 SEN0466 CO (DIP A0=1 A1=0) 0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
L. Switched loads on +5V_AUX: 850 nm illuminators, sample pump, break-beam
IR: 2 strings x (2 x 850 nm 1 W LED + 4.7R) = 2 x ~0.37 A from 5 V (Vf ~1.6 V each); Q1 low-side, PWM dimmable on GPIO12. Pump: 370-class diaphragm pump, ~0.3 A at 5 V, low-side Q2 + SS14 flyback; GPIO13 PWM sets sample flow. Gate network: 100R series (edge/ringing) + 100k pull-down = load OFF whil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
N. Wiring rules
All logic is 3.3 V: FC UARTs, Pi GPIO, LiDAR Tx, ESP32-C3. No level shifters. Single-point ground at the PM; signal harnesses carry their own GND wire. Wire gauges: battery/PM/ESC 12 AWG; fused branches 20 AWG; signals 26-28 AWG. Current envelope: hover ~25 A (calc), PM02 60 A cont./100 A burst -> 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
