https-shubhamsahu/surang-sutra-vishwakarma/electronics/kicad/surang-sutra/sutra-puck.kicad_sch

## KiCad design electronics/kicad/surang-sutra/sutra-puck.kicad_sch (2026-10-21)

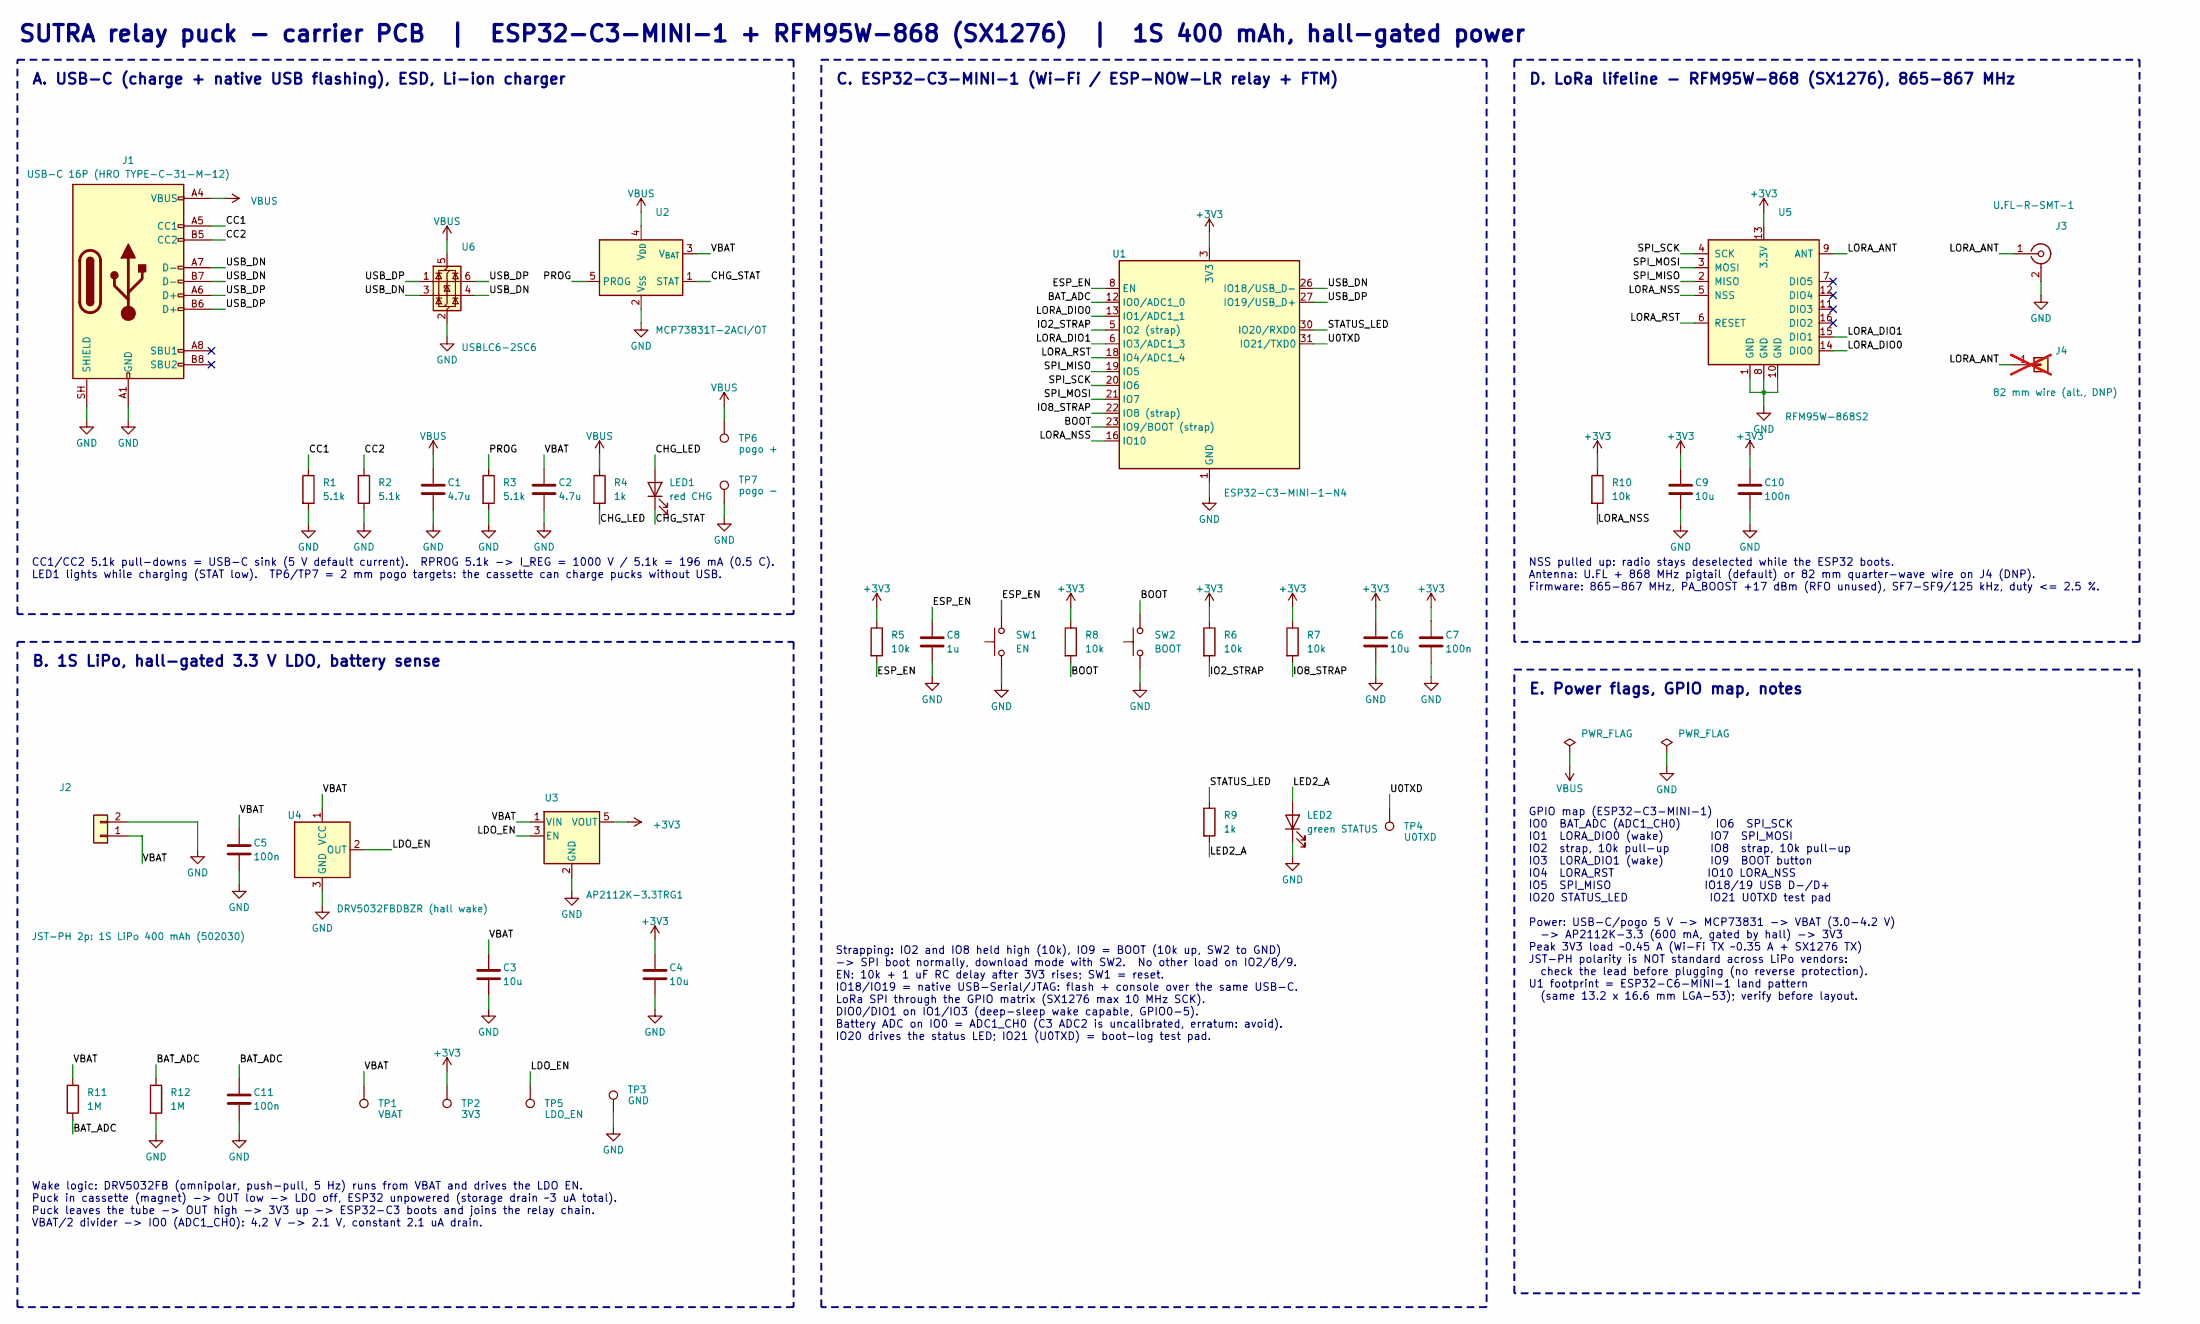
[picture p41: schematic sutra-puck.kicad_sch]

Parts:
C1, C2: 4.7u; C_0805_2012Metric; MPN X5R 10V 0805
C3, C4, C6, C9: 10u; C_0805_2012Metric; MPN X5R 10V 0805
C5, C7, C10, C11: 100n; C_0603_1608Metric; MPN X7R 16V 0603 100n
C8: 1u; C_0603_1608Metric; MPN X7R 16V 0603 1u
J1: USB-C 16P (HRO TYPE-C-31-M-12); USB_C_Receptacle_HRO_TYPE-C-31-M-12; MPN TYPE-C-31-M-12
J2: JST-PH 2p: 1S LiPo 400 mAh (502030); JST_PH_S2B-PH-SM4-TB_1x02-1MP_P2.00mm_Horizontal; MPN S2B-PH-SM4-TB
J3: U.FL-R-SMT-1; U.FL_Hirose_U.FL-R-SMT-1_Vertical; MPN U.FL-R-SMT-1(10)
J4: 82 mm wire (alt., DNP); SolderWire-0.127sqmm_1x01_D0.48mm_OD1mm; not fitted
LED1: red CHG; LED_0603_1608Metric; MPN red 0603
LED2: green STATUS; LED_0603_1608Metric; MPN green 0603
R1, R2, R3: 5.1k; R_0603_1608Metric; MPN 0603 5.1k 1%
R4, R9: 1k; R_0603_1608Metric; MPN 0603 1k 1%
R5, R6, R7, R8, R10: 10k; R_0603_1608Metric; MPN 0603 10k 1%
R11, R12: 1M; R_0603_1608Metric; MPN 0603 1M 1%
SW1: EN; SW_Push_1P1T_NO_CK_KMR2; MPN C&K KMR221G
SW2: BOOT; SW_Push_1P1T_NO_CK_KMR2; MPN C&K KMR221G
TP1: VBAT; TestPoint_Pad_D1.5mm
TP2: 3V3; TestPoint_Pad_D1.5mm
TP3: GND; TestPoint_Pad_D1.5mm
TP4: U0TXD; TestPoint_Pad_D1.5mm
TP5: LDO_EN; TestPoint_Pad_D1.5mm
TP6: pogo +; TestPoint_Pad_D2.0mm
TP7: pogo -; TestPoint_Pad_D2.0mm
U1: ESP32-C3-MINI-1-N4; ESP32-C6-MINI-1; MPN ESP32-C3-MINI-1-N4
U2: MCP73831T-2ACI/OT; SOT-23-5; MPN MCP73831T-2ACI/OT
U3: AP2112K-3.3TRG1; SOT-23-5; MPN AP2112K-3.3TRG1
U4: DRV5032FBDBZR (hall wake); SOT-23; MPN DRV5032FBDBZR
U5: RFM95W-868S2; HOPERF_RFM9XW_SMD; MPN RFM95W-868S2
U6: USBLC6-2SC6; SOT-23-6; MPN USBLC6-2SC6

Connections:
+3V3: C4.1, C6.1, C7.1, C9.1, C10.1, R5.1, R6.1, R7.1, R8.1, R10.1, TP2.1, U1.3 (3V3), U3.5 (VOUT), U5.13 (3.3V)
BAT_ADC: C11.1, R11.2, R12.1, U1.12 (IO0/ADC1_0)
BOOT: R8.2, SW2.2, U1.23 (IO9/BOOT (strap))
CC1: J1.A5 (CC1), R1.1
CC2: J1.B5 (CC2), R2.1
CHG_LED: LED1.2 (A), R4.2
CHG_STAT: LED1.1 (K), U2.1 (STAT)
ESP_EN: C8.1, R5.2, SW1.2, U1.8 (EN)
GND: C1.2, C2.2, C3.2, C4.2, C5.2, C6.2, C7.2, C8.2, C9.2, C10.2, C11.2, J1.A1 (GND), J1.A12 (GND), J1.B1 (GND), J1.B12 (GND), J1.SH (SHIELD), J2.2, J3.2 (Ext), LED2.1 (K), R1.2, R2.2, R3.2, R12.2, SW1.1, SW2.1, TP3.1, TP7.1, U1.1 (GND), U1.2 (GND), U1.11 (GND), U1.14 (GND), U1.36 (GND), U1.37 (GND), U1.38 (GND), U1.39 (GND), U1.40 (GND), U1.41 (GND), U1.42 (GND), U1.43 (GND), U1.44 (GND), U1.45 (GND), U1.46 (GND), U1.47 (GND), U1.48 (GND), U1.49 (GND), U1.50 (GND), U1.51 (GND), U1.52 (GND), U1.53 (GND), U2.2 (V_{SS}), U3.2 (GND), U4.3 (GND), U5.1 (GND), U5.8 (GND), U5.10 (GND), U6.2 (GND)
IO2_STRAP: R6.2, U1.5 (IO2 (strap))
IO8_STRAP: R7.2, U1.22 (IO8 (strap))
LDO_EN: TP5.1, U3.3 (EN), U4.2 (OUT)
LED2_A: LED2.2 (A), R9.2
LORA_ANT: J3.1 (In), J4.1, U5.9 (ANT)
LORA_DIO0: U1.13 (IO1/ADC1_1), U5.14 (DIO0)
LORA_DIO1: U1.6 (IO3/ADC1_3), U5.15 (DIO1)
LORA_NSS: R10.2, U1.16 (IO10), U5.5 (NSS)
LORA_RST: U1.18 (IO4/ADC1_4), U5.6 (RESET)
PROG: R3.1, U2.5 (PROG)
SPI_MISO: U1.19 (IO5), U5.2 (MISO)
SPI_MOSI: U1.21 (IO7), U5.3 (MOSI)
SPI_SCK: U1.20 (IO6), U5.4 (SCK)
STATUS_LED: R9.1, U1.30 (IO20/RXD0)
U0TXD: TP4.1, U1.31 (IO21/TXD0)
USB_DN: J1.A7 (D-), J1.B7 (D-), U1.26 (IO18/USB_D-), U6.3 (I/O2), U6.4 (I/O2)
USB_DP: J1.A6 (D+), J1.B6 (D+), U1.27 (IO19/USB_D+), U6.1 (I/O1), U6.6 (I/O1)
VBAT: C2.1, C3.1, C5.1, J2.1, R11.1, TP1.1, U2.3 (V_{BAT}), U3.1 (VIN), U4.1 (VCC)
VBUS: C1.1, J1.A4 (VBUS), J1.A9 (VBUS), J1.B4 (VBUS), J1.B9 (VBUS), R4.1, TP6.1, U2.4 (V_{DD}), U6.5 (VBUS)

Notes on the sheet:
SUTRA relay puck - carrier PCB | ESP32-C3-MINI-1 + RFM95W-868 (SX1276) | 1S 400 mAh, hall-gated power
A. USB-C (charge + native USB flashing), ESD, Li-ion charger
CC1/CC2 5.1k pull-downs = USB-C sink (5 V default current). RPROG 5.1k -> I_REG = 1000 V / 5.1k = 196 mA (0.5 C). LED1 lights while charging (STAT low). TP6/TP7 = 2 mm pogo targets: the cassette can charge pucks without USB.
B. 1S LiPo, hall-gated 3.3 V LDO, battery sense
Wake logic: DRV5032FB (omnipolar, push-pull, 5 Hz) runs from VBAT and drives the LDO EN. Puck in cassette (magnet) -> OUT low -> LDO off, ESP32 unpowered (storage drain ~3 uA total). Puck leaves the tube -> OUT high -> 3V3 up -> ESP32-C3 boots and joins the relay chain. VBAT/2 divider -> IO0 (ADC1_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
C. ESP32-C3-MINI-1 (Wi-Fi / ESP-NOW-LR relay + FTM)
Strapping: IO2 and IO8 held high (10k), IO9 = BOOT (10k up, SW2 to GND) -> SPI boot normally, download mode with SW2. No other load on IO2/8/9. EN: 10k + 1 uF RC delay after 3V3 rises; SW1 = reset. IO18/IO19 = native USB-Serial/JTAG: flash + console over the same USB-C. LoRa SPI through the GPIO ma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
D. LoRa lifeline - RFM95W-868 (SX1276), 865-867 MHz
NSS pulled up: radio stays deselected while the ESP32 boots. Antenna: U.FL + 868 MHz pigtail (default) or 82 mm quarter-wave wire on J4 (DNP). Firmware: 865-867 MHz, PA_BOOST +17 dBm (RFO unused), SF7-SF9/125 kHz, duty <= 2.5 %.
E. Power flags, GPIO map, notes
GPIO map (ESP32-C3-MINI-1) IO0 BAT_ADC (ADC1_CH0) IO6 SPI_SCK IO1 LORA_DIO0 (wake) IO7 SPI_MOSI IO2 strap, 10k pull-up IO8 strap, 10k pull-up IO3 LORA_DIO1 (wake) IO9 BOOT button IO4 LORA_RST IO10 LORA_NSS IO5 SPI_MISO IO18/19 USB D-/D+ IO20 STATUS_LED IO21 U0TXD test pad Power: USB-C/pogo 5 V -> M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
