https-shubhamsahu/surang-sutra-vishwakarma/electronics/scripts/build_avionics.py

"""Generate the SURANG avionics interconnect / power-distribution schematic (KiCad 10, connector level)."""
import sys, os
sys.path.insert(0, os.path.dirname(__file__))
from schgen import Sch
import custom_symbols as cs

OUT = os.path.join(os.path.dirname(__file__), '..', 'kicad', 'surang-sutra')
L = cs.LIB
R0603 = 'Resistor_SMD:R_0603_1608Metric'
R2512 = 'Resistor_SMD:R_2512_6332Metric'
BLUE, GREEN, AMBER = '29 78 216 1', '22 163 74 1', '217 119 6 1'

s = Sch('surang-avionics', paper='A2',
        title='SURANG avionics - interconnect + power distribution',
        date='2026-10-22', rev='S2-A',
        company='Team Palanteen, TSEC Mumbai - VK26-AU-PAI-0065',
        comments=['Vishwakarma Awards 2026-27 Stage 2 design baseline', 'Gas-free mock-gallery prototype; not intrinsically safe',
                  'Modules drawn at connector level; harness not yet built', 'Generated by electronics/scripts/build_avionics.py'])
for n, t in cs.SYMS.items():
    s.register_custom(f'{L}:{n}', t)


def vp(lib, ref, value, x, y, top, bot, fp='', mpn='', r=0, dnp=False):
    i = s.place(lib, ref, value, x, y, r=r, fp=fp, fields={'MPN': mpn} if mpn else None, dnp=dnp,
                refpos=(x + 2.54, y - 1.27, 0, 'left'), valpos=(x + 2.54, y + 1.27, 0, 'left'))
    a, b = sorted(i.pins.values(), key=lambda p: p['y'])[:2]
    s.net(i, a['number'], top)
    s.net(i, b['number'], bot)
    return i


def box(sym, ref, value, x, y, conns, mpn='', fp='', valpos=None):
    i = s.place(f'{L}:{sym}', ref, value, x, y, fields={'MPN': mpn} if mpn else None, fp=fp, valpos=valpos)
    for k, n in conns.items():
        if n is None:
            s.nc(i, k)
        else:
            s.net(i, k, n)
    return i


s.text(17.78, 17.78, 'SURANG avionics - power distribution and signal interconnect  |  6S 3300 mAh  |  Pixhawk 6C Mini + Raspberry Pi 5', 3.5, bold=True)

# =========================================================== P: 6S power
s.rect(15.24, 25.4, 203.2, 243.84, AMBER)
s.text(17.78, 27.94, 'P. 6S power: battery, power module, ESC, protected 5 V rails', 2.2, bold=True)
BT1 = s.place('Device:Battery', 'BT1', '6S LiPo 3300 mAh 95C (Tattu)', 30.48, 63.5, fields={'MPN': 'TAS33006S95X9'},
              refpos=(33.02, 60.96, 0, 'left'), valpos=(33.02, 66.04, 0, 'left'))
s.net(BT1, '1', 'BATT+')
s.net(BT1, '2', 'GND')
s.text(20.32, 76.2, '22.2 V nom, 25.2 V full,\n18.0 V min (3.0 V/cell)\nXT90-S anti-spark lead', 1.4)
J1 = s.place('Connector_Generic:Conn_01x02', 'J1', 'XT90 (vehicle side)', 73.66, 50.8, fp='Connector_AMASS:AMASS_XT90PW-M_1x02_P10.90mm_Horizontal',
             fields={'MPN': 'AMASS XT90H'}, refpos=(71.12, 45.72, 0, 'left'), valpos=(71.12, 56.9, 0, 'left'))
s.net(J1, '1', 'BATT+')
s.route(J1, '2', 'GND', [(-2.54, 0), (0, 5.08)])
U1 = box('PowerModule_PM02', 'U1', 'Holybro PM02 V3 (2-12S, 60 A cont.)', 60.96, 99.06,
         {'IN+': 'BATT+', 'IN-': 'GND', 'OUT+': 'VBAT_6S', 'OUT-': 'GND', 'PWR.1': 'FC_5V2', 'PWR.3': 'PM_CURR',
          'PWR.4': 'PM_VOLT', 'PWR.5': 'GND'}, mpn='Holybro PM02 V3')
C1 = s.place('Device:C_Polarized', 'C1', '470u 50V low-ESR', 104.14, 137.16, fp='Capacitor_THT:CP_Radial_D10.0mm_P5.00mm',
             fields={'MPN': 'Panasonic EEU-FR1H471'}, refpos=(106.68, 135.89, 0, 'left'), valpos=(106.68, 138.43, 0, 'left'))
s.net(C1, '1', 'VBAT_6S')
s.net(C1, '2', 'GND')
s.text(106.68, 141.0, '(solder at ESC pads)', 1.3)

U2 = s.place(f'{L}:ESC_4in1', 'U2', '4-in-1 ESC 6S 65 A (XRotor G2)', 134.62, 101.6, fields={'MPN': 'Hobbywing XRotor G2 65A 4in1'})
for k, n in {'VBAT+': 'VBAT_6S', 'VBAT-': 'GND', 'S1': 'ESC_S1', 'S2': 'ESC_S2', 'S3': 'ESC_S3', 'S4': 'ESC_S4',
             'SGND': 'GND'}.items():
    s.net(U2, k, n)
s.nc(U2, 'CUR')
s.nc(U2, 'TLM')
# motors aligned with the ESC phase pins
for m in range(1, 5):
    pa = U2.pin(f'M{m}A')
    mx = pa['x'] + 10.16 + 7.62
    my = pa['y'] + 2.54
    M = s.place(f'{L}:BLDC_Motor', f'M{m}', '2809 1280KV', mx, my, fields={'MPN': 'GEPRC SPEEDX2 2809 1280KV'},
                refpos=(mx + 7.62, my - 1.27, 0, 'left'), valpos=(mx + 7.62, my + 1.27, 0, 'left'))
    for ph in 'ABC':
        s.link(U2, f'M{m}{ph}', M, ph, f'M{m}_{ph}')
s.text(152.4, 152.4, 'Motor order (ArduPilot X):\nM1 front-R CCW, M2 rear-L CCW,\nM3 front-L CW, M4 rear-R CW\n7x4x3 tri-blade props', 1.3)

# fused 5 V branches
s.text(17.78, 152.4, 'Protected 5 V branches (fuse + TVS crowbar: reversed battery -> TVS conducts -> fuse opens)', 1.6, bold=True)
vp('Device:Fuse', 'F1', '3 A mini blade', 27.94, 172.72, 'VBAT_6S', 'VBUCK_IN', fp='Fuse:Fuse_Blade_Mini_directSolder', mpn='Littelfuse 0297003')
vp('Device:D_Zener', 'D1', 'SMBJ28A TVS', 53.34, 172.72, 'VBUCK_IN', 'GND', fp='Diode_SMD:D_SMB', mpn='SMBJ28A', r=270)
U3 = box('Buck_D36V50F5', 'U3', 'Pololu D36V50F5 (5 V 5.5 A)', 91.44, 172.72,
         {'VIN': 'VBUCK_IN', 'GND1': 'GND', 'EN': None, 'VOUT': '+5V1_PI', 'GND2': 'GND', 'PG': None}, mpn='Pololu #4091')
vp('Device:Fuse', 'F2', '2 A mini blade', 27.94, 213.36, 'VBAT_6S', 'VBEC_IN', fp='Fuse:Fuse_Blade_Mini_directSolder', mpn='Littelfuse 0297002')
vp('Device:D_Zener', 'D2', 'SMBJ28A TVS', 53.34, 213.36, 'VBEC_IN', 'GND', fp='Diode_SMD:D_SMB', mpn='SMBJ28A', r=270)
U4 = box('UBEC_5V', 'U4', '5 V / 3 A UBEC (2-6S)', 91.44, 213.36,
         {'VIN': 'VBEC_IN', 'GND1': 'GND', 'VOUT': '+5V_AUX', 'GND2': 'GND'}, mpn='ReadytoSky 2-6S 5V3A UBEC')
for x, net in [(132.08, 'BATT+'), (147.32, 'VBUCK_IN'), (162.56, 'VBEC_IN'), (177.8, 'GND')]:
    s.pwr_flag(x, 205.74, net, d=90)
s.text(129.54, 220.98, 'PWR_FLAGs: rails entering through passive\nfuses / connectors (ERC driver markers)', 1.3)
s.text(17.78, 228.6, 'Buck EN left open (internal pull-up = on); PG unused.  Pi fed by a 10 cm 20 AWG USB-C pigtail (no USB-PD):\n'
       'set usb_max_current_enable=1.  ESC branch is protected only by the keyed XT90 - never hot-plug.', 1.3)

# =========================================================== F: flight controller
s.rect(208.28, 25.4, 375.92, 243.84, BLUE)
s.text(210.82, 27.94, 'F. Flight controller, RC, cassette servo', 2.2, bold=True)
U5 = s.place(f'{L}:Pixhawk6C_Mini', 'U5', 'Holybro Pixhawk 6C Mini (ArduPilot Copter)', 294.64, 93.98,
             fields={'MPN': 'Holybro Pixhawk 6C Mini'})
for k, n in {'POWER1.1': 'FC_5V2', 'POWER1.3': 'PM_CURR', 'POWER1.4': 'PM_VOLT', 'POWER1.5': 'GND',
             'RC.1': 'RC_5V', 'RC.2': 'RC_IBUS', 'RC.3': 'GND',
             'TELEM1.1': 'FLOW_5V', 'TELEM1.2': 'T1_FC_TX', 'TELEM1.3': 'T1_FC_RX', 'TELEM1.6': 'GND',
             'TELEM2.2': 'MAV_FC_TX', 'TELEM2.3': 'MAV_FC_RX', 'TELEM2.6': 'GND',
             'AUX.1': 'ESC_S1', 'AUX.2': 'ESC_S2', 'AUX.3': 'ESC_S3', 'AUX.4': 'ESC_S4', 'AUX.5': 'SERVO_PWM',
             'AUX.GND': 'GND'}.items():
    s.net(U5, k, n)
for k in ('TELEM2.4', 'TELEM2.5', 'TELEM2.1'):
    s.nc(U5, k)
box('RX_FS-iA6B', 'U6', 'FlySky FS-iA6B (iBUS)', 236.22, 152.4, {'5V': 'RC_5V', 'GND': 'GND', 'IBUS': 'RC_IBUS'},
    mpn='FlySky FS-iA6B')
box('OptFlow_3901L0X', 'U7', 'MTF-01 flow + ToF (recommended)', 236.22, 182.88,
    {'5V': 'FLOW_5V', 'GND': 'GND', 'TX': 'T1_FC_RX', 'RX': 'T1_FC_TX'}, mpn='MicoAir MTF-01')
M5 = s.place('Motor:Motor_Servo', 'M5', 'MG90S (puck escapement cam)', 330.2, 160.02, fields={'MPN': 'MG90S'},
             refpos=(335.28, 154.94, 0, 'left'), valpos=(335.28, 166.37, 0, 'left'))
s.net(M5, '1', 'SERVO_PWM')
s.net(M5, '2', '+5V_AUX')
s.net(M5, '3', 'GND')
s.text(210.82, 205.74, 'TELEM2 <-> Pi UART0: MAVLink2 921600 8N1, no flow control (BRD_SER2_RTSCTS=0).  VCC pin not connected.\n'
       'ESC: DShot600 on FMU AUX1-4 (SERVO9-12; IO MAIN outputs do not do DShot).  Servo: AUX5 = SERVO13 PWM.\n'
       'RC: FS-iA6B iBUS -> RC IN (if not decoded, move to a spare UART with SERIALx_PROTOCOL=23).\n'
       'TELEM1: optical flow + ToF (MSP, 115200) for GPS-free Loiter in the gallery.\n'
       'Failsafes: RC + GCS loss -> brake/hold -> land; battery 2-stage (BATT_LOW/CRT); props idle when perched.', 1.3)

# =========================================================== C: companion + sensors
s.rect(381, 25.4, 579.12, 243.84, GREEN)
s.text(383.54, 27.94, 'C. Companion computer, LiDAR, camera, scout radio node', 2.2, bold=True)
U8 = s.place(f'{L}:RaspberryPi5', 'U8', 'Raspberry Pi 5 8GB + active cooler', 474.98, 88.9, fields={'MPN': 'SC1112'})
for k, n in {'USBC.VBUS': '+5V1_PI', 'USBC.GND': 'GND', '8': 'MAV_FC_RX', '10': 'MAV_FC_TX', '29': 'LIDAR_TX',
             '24': 'SCOUT_RX', '21': 'SCOUT_TX', 'CAM1': 'CSI_CAM1', '1': '+3V3_PI', '3': 'I2C1_SDA', '5': 'I2C1_SCL',
             '31': 'I2C3_SDA', '26': 'I2C3_SCL', '11': 'BEAM_OUT', '32': 'IR_PWM', '33': 'PUMP_PWM', '6': 'GND'}.items():
    s.net(U8, k, n)
s.nc(U8, '7')
box('STL-19P', 'U9', 'LDROBOT STL-19P (LD19) 2D LiDAR', 414.02, 152.4,
    {'P5V': '+5V_AUX', 'GND': 'GND', 'TX': 'LIDAR_TX', 'PWM': 'GND'}, mpn='STL-19P / D500 kit')
box('IMX327_Cam', 'U10', 'Waveshare IMX327 2MP IR-CUT (A)', 414.02, 182.88, {'CSI': 'CSI_CAM1'}, mpn='Waveshare 23752')
U11 = box('XIAO_ESP32C3', 'U11', 'Seeed XIAO ESP32C3 (scout node, U.FL)', 492.76, 152.4,
          {'5V': '+5V_AUX', 'GND': 'GND', '3V3': '+3V3_SCOUT', 'D6': 'SCOUT_TX', 'D7': 'SCOUT_RX', 'D8': 'S_SCK',
           'D10': 'S_MOSI', 'D9': 'S_MISO', 'D3': 'S_NSS', 'D2': 'S_RST', 'D1': 'S_DIO0', 'D4': 'S_DIO1'},
          mpn='Seeed 113991054')
U12 = s.place('RF_Module:RFM95W-868S2', 'U12', 'RFM95W-868S2 (scout LoRa)', 548.64, 205.74, fields={'MPN': 'RFM95W-868S2'}, fp='RF_Module:HOPERF_RFM9XW_SMD',
              refpos=(551.18, 190.5, 0, 'left'), valpos=(552.45, 228.6, 0, 'left'))
for k, n in {'4': 'S_SCK', '3': 'S_MOSI', '2': 'S_MISO', '5': 'S_NSS', '6': 'S_RST', '14': 'S_DIO0', '15': 'S_DIO1',
             '13': '+3V3_SCOUT'}.items():
    s.net(U12, k, n)
for k in ('7', '12', '11', '16'):
    s.nc(U12, k)
s.tie(U12, ['1', '8', '10'], 'GND')
J2 = s.place('Connector:Conn_Coaxial', 'J2', '868 MHz whip', 571.5, 198.12, fp='Connector_Coaxial:U.FL_Hirose_U.FL-R-SMT-1_Vertical',
             refpos=(566.42, 193.04, 0, 'left'), valpos=(562.61, 190.5, 0, 'left'))
s.link(U12, '9', J2, '1', 'S_ANT')
s.net(J2, '2', 'GND')
s.text(383.54, 205.74, 'UART0 GPIO14/15 = MAVLink (FC TELEM2)\n'
       'UART2 GPIO5 RX = LiDAR 230400 (dtoverlay=uart2-pi5)\n'
       'UART3 GPIO8/9 = scout node 921600 (uart3-pi5)\n'
       'LiDAR PWM tied to GND = internal 10 Hz scan\n'
       'IMX327: 22->15-pin FPC, 2-lane, dtoverlay=imx290\n'
       'Scout XIAO 3V3 LDO feeds RFM95W (peak ~0.47 A)', 1.3)

# =========================================================== S: I2C sensors
s.rect(15.24, 248.92, 203.2, 405.13, GREEN)
s.text(17.78, 251.46, 'S. I2C sensor buses (3.3 V, Pi-hosted)', 2.2, bold=True)
vp('Device:R', 'R2', '4.7k', 27.94, 274.32, '+3V3_PI', 'I2C3_SDA', fp=R0603)
vp('Device:R', 'R3', '4.7k', 40.64, 274.32, '+3V3_PI', 'I2C3_SCL', fp=R0603)
box('MLX90640', 'U15', 'MLX90640 110 deg (I2C1 0x33)', 91.44, 274.32,
    {'VIN': '+3V3_PI', 'GND': 'GND', 'SDA': 'I2C1_SDA', 'SCL': 'I2C1_SCL'}, mpn='7Semi MLX90640 110deg')
box('SEN0465_O2', 'U16', 'DFRobot SEN0465 O2 (I2C3 0x74)', 154.94, 274.32,
    {'VCC': '+3V3_PI', 'GND': 'GND', 'SDA': 'I2C3_SDA', 'SCL': 'I2C3_SCL'}, mpn='DFRobot SEN0465')
box('SEN0466_CO', 'U17', 'DFRobot SEN0466 CO (I2C3 0x75)', 91.44, 307.34,
    {'VCC': '+3V3_PI', 'GND': 'GND', 'SDA': 'I2C3_SDA', 'SCL': 'I2C3_SCL'}, mpn='DFRobot SEN0466')
box('SEN0467_H2S', 'U18', 'DFRobot SEN0467 H2S (I2C3 0x76)', 154.94, 307.34,
    {'VCC': '+3V3_PI', 'GND': 'GND', 'SDA': 'I2C3_SDA', 'SCL': 'I2C3_SCL'}, mpn='DFRobot SEN0467')
s.text(17.78, 330.2,
       'I2C ADDRESS MAP\n'
       'I2C1 (GPIO2 SDA / GPIO3 SCL), 400 kHz-1 MHz, Pi on-board fixed pull-ups:\n'
       '   0x33  MLX90640 thermal array (alone on the bus so it can run FM+)\n'
       'I2C3 (GPIO6 SDA / GPIO7 SCL, dtoverlay=i2c3-pi5), 100 kHz, R2/R3 4.7k pull-ups:\n'
       '   0x74  SEN0465 O2   (DIP A0=0 A1=0)\n'
       '   0x75  SEN0466 CO   (DIP A0=1 A1=0)\n'
       '   0x76  SEN0467 H2S  (DIP A0=0 A1=1)\n'
       '   0x77  DFRobot factory default - left unused so a fresh sensor cannot collide\n'
       'Gas boards: SEL DIP = 0 (I2C), powered from 3V3 so SDA/SCL never exceed 3.3 V.\n'
       'CH4 NDIR (Ambetronics OEM) is planned on UART/RS-485 via an adapter, not on these buses.', 1.3)

# =========================================================== L: switched loads
s.rect(208.28, 248.92, 469.9, 405.13, BLUE)
s.text(210.82, 251.46, 'L. Switched loads on +5V_AUX: 850 nm illuminators, sample pump, break-beam', 2.2, bold=True)
# IR LED strings
vp('Device:R', 'R4', '4.7R 1W', 223.52, 274.32, '+5V_AUX', 'IR_A1', fp=R2512, mpn='2512 4.7R 1W')
vp('Device:LED', 'D3', '850nm 1W', 223.52, 289.56, 'IR_A1', 'IR_M1', fp='LED_SMD:LED_1W_3W_R8', r=90)
vp('Device:LED', 'D4', '850nm 1W', 223.52, 304.8, 'IR_M1', 'IR_K', fp='LED_SMD:LED_1W_3W_R8', r=90)
vp('Device:R', 'R5', '4.7R 1W', 243.84, 274.32, '+5V_AUX', 'IR_A2', fp=R2512, mpn='2512 4.7R 1W')
vp('Device:LED', 'D5', '850nm 1W', 243.84, 289.56, 'IR_A2', 'IR_M2', fp='LED_SMD:LED_1W_3W_R8', r=90)
vp('Device:LED', 'D6', '850nm 1W', 243.84, 304.8, 'IR_M2', 'IR_K', fp='LED_SMD:LED_1W_3W_R8', r=90)
Q1 = s.place('Transistor_FET:AO3400A', 'Q1', 'AO3400A', 266.7, 325.12, fields={'MPN': 'AO3400A'},
             refpos=(270.51, 323.85, 0, 'left'), valpos=(270.51, 326.39, 0, 'left'))
s.net(Q1, '3', 'IR_K')
s.net(Q1, '2', 'GND')
s.net(Q1, '1', 'IR_G')
vp('Device:R', 'R6', '100R', 223.52, 342.9, 'IR_PWM', 'IR_G', fp=R0603)
vp('Device:R', 'R7', '100k', 243.84, 342.9, 'IR_G', 'GND', fp=R0603)
# pump
M6 = s.place('Motor:Motor_DC', 'M6', '370 diaphragm pump 6 V (run at 5 V)', 312.42, 287.02, fields={'MPN': '370 micro air pump'},
             refpos=(317.5, 284.48, 0, 'left'), valpos=(317.5, 287.02, 0, 'left'))
s.net(M6, '1', '+5V_AUX')
s.net(M6, '2', 'PUMP_K')
vp('Device:D_Schottky', 'D7', 'SS14 flyback', 289.56, 289.56, '+5V_AUX', 'PUMP_K', fp='Diode_SMD:D_SMA', mpn='SS14', r=270)
Q2 = s.place('Transistor_FET:AO3400A', 'Q2', 'AO3400A', 335.28, 325.12, fields={'MPN': 'AO3400A'},
             refpos=(339.09, 323.85, 0, 'left'), valpos=(339.09, 326.39, 0, 'left'))
s.net(Q2, '3', 'PUMP_K')
s.net(Q2, '2', 'GND')
s.net(Q2, '1', 'PUMP_G')
vp('Device:R', 'R8', '100R', 292.1, 342.9, 'PUMP_PWM', 'PUMP_G', fp=R0603)
vp('Device:R', 'R9', '100k', 312.42, 342.9, 'PUMP_G', 'GND', fp=R0603)
# break-beam
box('BreakBeam_TX', 'U13', 'IR break-beam emitter (Adafruit 2167)', 391.16, 276.86, {'VCC': '+5V_AUX', 'GND': 'GND'},
    mpn='Adafruit 2167')
box('BreakBeam_RX', 'U14', 'IR break-beam receiver', 391.16, 302.26, {'VCC': '+5V_AUX', 'GND': 'GND', 'OUT': 'BEAM_OUT'},
    mpn='Adafruit 2167')
vp('Device:R', 'R1', '10k', 434.34, 304.8, '+3V3_PI', 'BEAM_OUT', fp=R0603)
s.text(210.82, 360.68,
       'IR: 2 strings x (2 x 850 nm 1 W LED + 4.7R) = 2 x ~0.37 A from 5 V (Vf ~1.6 V each); Q1 low-side, PWM dimmable on GPIO12.\n'
       'Pump: 370-class diaphragm pump, ~0.3 A at 5 V, low-side Q2 + SS14 flyback; GPIO13 PWM sets sample flow.\n'
       'Gate network: 100R series (edge/ringing) + 100k pull-down = load OFF while the Pi boots or is unpowered.\n'
       'AO3400A: logic-level (Vgs(th) <= 1.45 V, Rds(on) ~ 40-50 mOhm at 2.5-4.5 V), 30 V / 5.7 A.\n'
       'Break-beam receiver is open-collector: pulled up to the Pi 3V3 (R1) so 5 V never reaches GPIO17.', 1.3)

# =========================================================== N: notes
s.rect(474.98, 248.92, 579.12, 367.03, AMBER)
s.text(477.52, 251.46, 'N. Wiring rules', 2.2, bold=True)
s.text(477.52, 259.08,
       'All logic is 3.3 V: FC UARTs, Pi GPIO,\n'
       'LiDAR Tx, ESP32-C3. No level shifters.\n'
       'Single-point ground at the PM; signal\n'
       'harnesses carry their own GND wire.\n'
       '\n'
       'Wire gauges: battery/PM/ESC 12 AWG;\n'
       'fused branches 20 AWG; signals 26-28 AWG.\n'
       '\n'
       'Current envelope: hover ~25 A (calc),\n'
       'PM02 60 A cont./100 A burst -> cap total\n'
       'at 80 A with MOT_BAT_CURR_MAX (amber).\n'
       '\n'
       'Radios: 2.4 GHz RC + ESP-NOW-LR share\n'
       'the band - keep RC on high channel hop\n'
       'and the scout on Wi-Fi ch 1/6/11 plan.\n'
       'LoRa 865-867 MHz, PA_BOOST <= +17 dBm.\n'
       '\n'
       'Not built; values are design targets.', 1.3)

errs = s.check_geometry()
if errs:
    print('\n'.join(errs))
    raise SystemExit('geometry errors')
s.write(os.path.join(OUT, 'surang-avionics.kicad_sch'))
s.save_intent(os.path.join(os.path.dirname(__file__), 'avionics_intent.pkl'))
print('wrote surang-avionics.kicad_sch; parts:', len(s.insts))
