https-shubhamsahu/surang-sutra-vishwakarma/electronics/scripts/build_puck.py

"""Generate the SUTRA puck carrier schematic (KiCad 10)."""
import sys, os
sys.path.insert(0, os.path.dirname(__file__))
from schgen import Sch
import custom_symbols as cs

OUT = os.path.join(os.path.dirname(__file__), '..', 'kicad', 'surang-sutra')
R0603 = 'Resistor_SMD:R_0603_1608Metric'
C0603 = 'Capacitor_SMD:C_0603_1608Metric'
C0805 = 'Capacitor_SMD:C_0805_2012Metric'
LED0603 = 'LED_SMD:LED_0603_1608Metric'

s = Sch('sutra-puck', paper='A3',
        title='SUTRA relay puck - carrier board (ESP32-C3 + SX1276)',
        date='2026-10-22', rev='S2-A',
        company='Team Palanteen, TSEC Mumbai - VK26-AU-PAI-0065',
        comments=['Vishwakarma Awards 2026-27 Stage 2 design baseline', 'Gas-free mock-gallery prototype; not intrinsically safe',
                  'PCB layout not started (roadmap Month 1)', 'Generated by electronics/scripts/build_puck.py'])
for n, t in cs.SYMS.items():
    s.register_custom(f'{cs.LIB}:{n}', t)


def vp(lib, ref, value, x, y, top, bot, fp, mpn='', dnp=False, r=0):
    i = s.place(lib, ref, value, x, y, r=r, fp=fp, fields={'MPN': mpn} if mpn else None, dnp=dnp,
                refpos=(x + 2.54, y - 1.27, 0, 'left') if r else None, valpos=(x + 2.54, y + 1.27, 0, 'left') if r else None)
    a, b = sorted(i.pins.values(), key=lambda p: p['y'])[:2]   # upper pin, lower pin
    s.net(i, a['number'], top)
    s.net(i, b['number'], bot)
    return i


def R(ref, value, x, y, top, bot, mpn=''):
    return vp('Device:R', ref, value, x, y, top, bot, R0603, mpn or f'0603 {value} 1%')


def C(ref, value, x, y, top, bot, fp=C0603, mpn=''):
    return vp('Device:C', ref, value, x, y, top, bot, fp, mpn or f'X7R 16V 0603 {value}')


def TP(ref, value, x, y, net, up=True, fp='TestPoint:TestPoint_Pad_D1.5mm'):
    r = 180 if up else 0
    i = s.place('Connector:TestPoint', ref, value, x, y, r=r, fp=fp, in_bom=False,
                refpos=(x + 2.54, y + (3.3 if up else -4.3), 0, 'left'), valpos=(x + 2.54, y + (5.3 if up else -2.3), 0, 'left'))
    s.net(i, '1', net)
    return i


BLUE = '29 78 216 1'
GREEN = '22 163 74 1'

# ------------------------------------------------------------------ title
s.text(15.24, 16.51, 'SUTRA relay puck - carrier PCB  |  ESP32-C3-MINI-1 + RFM95W-868 (SX1276)  |  1S 400 mAh, hall-gated power', 3.0, bold=True)

# ------------------------------------------------------------------ block A: USB-C, ESD, charger
s.rect(15.24, 22.86, 157.48, 124.46, BLUE)
s.text(17.78, 25.4, 'A. USB-C (charge + native USB flashing), ESD, Li-ion charger', 2.0, bold=True)
J1 = s.place('Connector:USB_C_Receptacle_USB2.0_16P', 'J1', 'USB-C 16P (HRO TYPE-C-31-M-12)', 35.56, 63.5,
             fp='Connector_USB:USB_C_Receptacle_HRO_TYPE-C-31-M-12', fields={'MPN': 'TYPE-C-31-M-12'})
s.net(J1, 'A4', 'VBUS')
s.net(J1, 'A5', 'CC1')
s.net(J1, 'B5', 'CC2')
s.net(J1, 'A7', 'USB_DN')
s.net(J1, 'B7', 'USB_DN')
s.net(J1, 'A6', 'USB_DP')
s.net(J1, 'B6', 'USB_DP')
s.nc(J1, 'A8')
s.nc(J1, 'B8')
s.net(J1, 'A1', 'GND')
s.net(J1, 'SH', 'GND')
R('R1', '5.1k', 68.58, 101.6, 'CC1', 'GND', '0603 5.1k 1%')
R('R2', '5.1k', 78.74, 101.6, 'CC2', 'GND', '0603 5.1k 1%')

U6 = s.place('Power_Protection:USBLC6-2SC6', 'U6', 'USBLC6-2SC6', 93.98, 63.5, fields={'MPN': 'USBLC6-2SC6'},
             refpos=(96.52, 57.15, 0, 'left'), valpos=(96.52, 75.57, 0, 'left'))
s.net(U6, '1', 'USB_DP')
s.net(U6, '6', 'USB_DP')
s.net(U6, '3', 'USB_DN')
s.net(U6, '4', 'USB_DN')
s.net(U6, '5', 'VBUS')
s.net(U6, '2', 'GND')

U2 = s.place('Battery_Management:MCP73831-2-OT', 'U2', 'MCP73831T-2ACI/OT', 129.54, 60.96, fields={'MPN': 'MCP73831T-2ACI/OT'},
             refpos=(132.08, 50.8, 0, 'left'), valpos=(132.08, 72.39, 0, 'left'))
s.net(U2, '4', 'VBUS')
s.net(U2, '2', 'GND')
s.net(U2, '3', 'VBAT')
s.net(U2, '1', 'CHG_STAT')
s.net(U2, '5', 'PROG')
C('C1', '4.7u', 91.44, 101.6, 'VBUS', 'GND', C0805, 'X5R 10V 0805')
R('R3', '5.1k', 101.6, 101.6, 'PROG', 'GND', '0603 5.1k 1%')
C('C2', '4.7u', 111.76, 101.6, 'VBAT', 'GND', C0805, 'X5R 10V 0805')
R('R4', '1k', 121.92, 101.6, 'VBUS', 'CHG_LED')
vp('Device:LED', 'LED1', 'red CHG', 132.08, 101.6, 'CHG_LED', 'CHG_STAT', LED0603, 'red 0603', r=90)
TP('TP6', 'pogo +', 144.78, 88.9, 'VBUS', up=True, fp='TestPoint:TestPoint_Pad_D2.0mm')
TP('TP7', 'pogo -', 144.78, 104.14, 'GND', up=False, fp='TestPoint:TestPoint_Pad_D2.0mm')
s.text(17.78, 114.3, 'CC1/CC2 5.1k pull-downs = USB-C sink (5 V default current).  RPROG 5.1k -> I_REG = 1000 V / 5.1k = 196 mA (0.5 C).\n'
       'LED1 lights while charging (STAT low).  TP6/TP7 = 2 mm pogo targets: the cassette can charge pucks without USB.', 1.4)

# ------------------------------------------------------------------ block B: battery, hall wake, LDO, sense
s.rect(15.24, 129.54, 157.48, 251.46, GREEN)
s.text(17.78, 132.08, 'B. 1S LiPo, hall-gated 3.3 V LDO, battery sense', 2.0, bold=True)
J2 = s.place('Connector_Generic:Conn_01x02', 'J2', 'JST-PH 2p: 1S LiPo 400 mAh (502030)', 30.48, 165.1, r=180,
             fp='Connector_JST:JST_PH_S2B-PH-SM4-TB_1x02-1MP_P2.00mm_Horizontal', fields={'MPN': 'S2B-PH-SM4-TB'},
             refpos=(22.86, 156.21, 0, 'left'), valpos=(17.78, 183.52, 0, 'left'))
s.route(J2, '1', 'VBAT', [(2.54, 0), (0, 5.08)])
s.route(J2, '2', 'GND', [(12.7, 0), (0, 5.08)])

U4 = s.place(f'{cs.LIB}:DRV5032xxDBZ', 'U4', 'DRV5032FBDBZR (hall wake)', 71.12, 167.64, fields={'MPN': 'DRV5032FBDBZR'},
             valpos=(73.66, 178.44, 0, 'left'))
s.net(U4, '1', 'VBAT')
s.net(U4, '3', 'GND')
s.net(U4, '2', 'LDO_EN', stub=5.08)
C('C5', '100n', 55.88, 167.64, 'VBAT', 'GND')

U3 = s.place('Regulator_Linear:AP2112K-3.3', 'U3', 'AP2112K-3.3TRG1', 116.84, 165.1,
             fp='Package_TO_SOT_SMD:SOT-23-5', fields={'MPN': 'AP2112K-3.3TRG1'},
             refpos=(111.76, 158.12, 0, 'left'), valpos=(119.38, 175.9, 0, 'left'))
s.net(U3, '1', 'VBAT')
s.net(U3, '3', 'LDO_EN')
s.net(U3, '2', 'GND')
s.net(U3, '5', '+3V3')
C('C3', '10u', 101.6, 190.5, 'VBAT', 'GND', C0805, 'X5R 10V 0805')
C('C4', '10u', 132.08, 190.5, '+3V3', 'GND', C0805, 'X5R 10V 0805')

R('R11', '1M', 25.4, 213.36, 'VBAT', 'BAT_ADC', '0603 1M 1%')
R('R12', '1M', 40.64, 213.36, 'BAT_ADC', 'GND', '0603 1M 1%')
C('C11', '100n', 55.88, 213.36, 'BAT_ADC', 'GND')
TP('TP1', 'VBAT', 78.74, 210.82, 'VBAT', up=True)
TP('TP2', '3V3', 93.98, 210.82, '+3V3', up=True)
TP('TP5', 'LDO_EN', 109.22, 210.82, 'LDO_EN', up=True)
TP('TP3', 'GND', 124.46, 215.9, 'GND', up=False)
s.text(17.78, 228.6, 'Wake logic: DRV5032FB (omnipolar, push-pull, 5 Hz) runs from VBAT and drives the LDO EN.\n'
       'Puck in cassette (magnet) -> OUT low -> LDO off, ESP32 unpowered (storage drain ~3 uA total).\n'
       'Puck leaves the tube -> OUT high -> 3V3 up -> ESP32-C3 boots and joins the relay chain.\n'
       'VBAT/2 divider -> IO0 (ADC1_CH0): 4.2 V -> 2.1 V, constant 2.1 uA drain.', 1.4)

# ------------------------------------------------------------------ block C: ESP32-C3
s.rect(162.56, 22.86, 284.48, 251.46, BLUE)
s.text(165.1, 25.4, 'C. ESP32-C3-MINI-1 (Wi-Fi / ESP-NOW-LR relay + FTM)', 2.0, bold=True)
U1 = s.place(f'{cs.LIB}:ESP32-C3-MINI-1', 'U1', 'ESP32-C3-MINI-1-N4', 233.68, 78.74, fields={'MPN': 'ESP32-C3-MINI-1-N4'},
             valpos=(236.22, 102.24, 0, 'left'))
s.net(U1, '3', '+3V3')
s.net(U1, '1', 'GND')
for pin, net in [('8', 'ESP_EN'), ('12', 'BAT_ADC'), ('13', 'LORA_DIO0'), ('5', 'IO2_STRAP'), ('6', 'LORA_DIO1'),
                 ('18', 'LORA_RST'), ('19', 'SPI_MISO'), ('20', 'SPI_SCK'), ('21', 'SPI_MOSI'), ('22', 'IO8_STRAP'),
                 ('23', 'BOOT'), ('16', 'LORA_NSS'), ('26', 'USB_DN'), ('27', 'USB_DP'), ('30', 'STATUS_LED'), ('31', 'U0TXD')]:
    s.net(U1, pin, net)

R('R5', '10k', 172.72, 129.54, '+3V3', 'ESP_EN')
C('C8', '1u', 182.88, 129.54, 'ESP_EN', 'GND')
vp('Switch:SW_Push', 'SW1', 'EN', 195.58, 129.54, 'ESP_EN', 'GND', 'Button_Switch_SMD:SW_Push_1P1T_NO_CK_KMR2', 'C&K KMR221G', r=90)
R('R8', '10k', 208.28, 129.54, '+3V3', 'BOOT')
vp('Switch:SW_Push', 'SW2', 'BOOT', 220.98, 129.54, 'BOOT', 'GND', 'Button_Switch_SMD:SW_Push_1P1T_NO_CK_KMR2', 'C&K KMR221G', r=90)
R('R6', '10k', 233.68, 129.54, '+3V3', 'IO2_STRAP')
R('R7', '10k', 248.92, 129.54, '+3V3', 'IO8_STRAP')
C('C6', '10u', 264.16, 129.54, '+3V3', 'GND', C0805, 'X5R 10V 0805')
C('C7', '100n', 274.32, 129.54, '+3V3', 'GND')
R('R9', '1k', 233.68, 162.56, 'STATUS_LED', 'LED2_A')
vp('Device:LED', 'LED2', 'green STATUS', 248.92, 162.56, 'LED2_A', 'GND', LED0603, 'green 0603', r=90)
TP('TP4', 'U0TXD', 266.7, 160.02, 'U0TXD', up=True)
s.text(165.1, 185.42, 'Strapping: IO2 and IO8 held high (10k), IO9 = BOOT (10k up, SW2 to GND)\n'
       '-> SPI boot normally, download mode with SW2.  No other load on IO2/8/9.\n'
       'EN: 10k + 1 uF RC delay after 3V3 rises; SW1 = reset.\n'
       'IO18/IO19 = native USB-Serial/JTAG: flash + console over the same USB-C.\n'
       'LoRa SPI through the GPIO matrix (SX1276 max 10 MHz SCK).\n'
       'DIO0/DIO1 on IO1/IO3 (deep-sleep wake capable, GPIO0-5).\n'
       'Battery ADC on IO0 = ADC1_CH0 (C3 ADC2 is uncalibrated, erratum: avoid).\n'
       'IO20 drives the status LED; IO21 (U0TXD) = boot-log test pad.', 1.4)

# ------------------------------------------------------------------ block D: LoRa
s.rect(289.56, 22.86, 404.14, 129.54, GREEN)
s.text(292.1, 25.4, 'D. LoRa lifeline - RFM95W-868 (SX1276), 865-867 MHz', 2.0, bold=True)
U5 = s.place('RF_Module:RFM95W-868S2', 'U5', 'RFM95W-868S2', 335.28, 66.04, fields={'MPN': 'RFM95W-868S2'}, fp='RF_Module:HOPERF_RFM9XW_SMD',
             refpos=(337.82, 50.8, 0, 'left'), valpos=(339.09, 88.27, 0, 'left'))
for pin, net in [('4', 'SPI_SCK'), ('3', 'SPI_MOSI'), ('2', 'SPI_MISO'), ('5', 'LORA_NSS'), ('6', 'LORA_RST'),
                 ('9', 'LORA_ANT'), ('14', 'LORA_DIO0'), ('15', 'LORA_DIO1')]:
    s.net(U5, pin, net)
for pin in ('7', '12', '11', '16'):
    s.nc(U5, pin)
s.net(U5, '13', '+3V3')
s.tie(U5, ['1', '8', '10'], 'GND')
J3 = s.place('Connector:Conn_Coaxial', 'J3', 'U.FL-R-SMT-1', 386.08, 58.42,
             fp='Connector_Coaxial:U.FL_Hirose_U.FL-R-SMT-1_Vertical', fields={'MPN': 'U.FL-R-SMT-1(10)'},
             refpos=(388.62, 53.34, 0, 'left'), valpos=(377.19, 49.53, 0, 'left'))
s.net(J3, '1', 'LORA_ANT')
s.net(J3, '2', 'GND')
J4 = s.place('Connector_Generic:Conn_01x01', 'J4', '82 mm wire (alt., DNP)', 386.08, 78.74,
             fp='Connector_Wire:SolderWire-0.127sqmm_1x01_D0.48mm_OD1mm', dnp=True,
             refpos=(388.62, 76.2, 0, 'left'), valpos=(377.19, 83.82, 0, 'left'))
s.net(J4, '1', 'LORA_ANT')
R('R10', '10k', 304.8, 101.6, '+3V3', 'LORA_NSS')
C('C9', '10u', 320.04, 101.6, '+3V3', 'GND', C0805, 'X5R 10V 0805')
C('C10', '100n', 332.74, 101.6, '+3V3', 'GND')
s.text(292.1, 114.3, 'NSS pulled up: radio stays deselected while the ESP32 boots.\n'
       'Antenna: U.FL + 868 MHz pigtail (default) or 82 mm quarter-wave wire on J4 (DNP).\n'
       'Firmware: 865-867 MHz, PA_BOOST +17 dBm (RFO unused), SF7-SF9/125 kHz, duty <= 2.5 %.', 1.4)

# ------------------------------------------------------------------ PWR flags + notes
s.rect(289.56, 134.62, 404.14, 248.92, BLUE)
s.text(292.1, 137.16, 'E. Power flags, GPIO map, notes', 2.0, bold=True)
s.pwr_flag(299.72, 149.86, 'VBUS', d=90)
s.pwr_flag(317.5, 149.86, 'GND', d=90)
s.text(292.1, 160.02,
       'GPIO map (ESP32-C3-MINI-1)\n'
       'IO0  BAT_ADC (ADC1_CH0)      IO6  SPI_SCK\n'
       'IO1  LORA_DIO0 (wake)        IO7  SPI_MOSI\n'
       'IO2  strap, 10k pull-up       IO8  strap, 10k pull-up\n'
       'IO3  LORA_DIO1 (wake)        IO9  BOOT button\n'
       'IO4  LORA_RST                IO10 LORA_NSS\n'
       'IO5  SPI_MISO                IO18/19 USB D-/D+\n'
       'IO20 STATUS_LED              IO21 U0TXD test pad\n'
       '\n'
       'Power: USB-C/pogo 5 V -> MCP73831 -> VBAT (3.0-4.2 V)\n'
       '  -> AP2112K-3.3 (600 mA, gated by hall) -> 3V3\n'
       'Peak 3V3 load ~0.45 A (Wi-Fi TX ~0.35 A + SX1276 TX)\n'
       'JST-PH polarity is NOT standard across LiPo vendors:\n'
       '  check the lead before plugging (no reverse protection).\n'
       'U1 footprint = ESP32-C6-MINI-1 land pattern\n'
       '  (same 13.2 x 16.6 mm LGA-53); verify before layout.', 1.4)

errs = s.check_geometry()
if errs:
    print('\n'.join(errs))
    raise SystemExit('geometry errors')
os.makedirs(OUT, exist_ok=True)
s.write(os.path.join(OUT, 'sutra-puck.kicad_sch'))
s.save_intent(os.path.join(os.path.dirname(__file__), 'puck_intent.pkl'))
print('wrote sutra-puck.kicad_sch; parts:', len(s.insts))
