https-shubhamsahu/surang-sutra-vishwakarma/(commit log)

2026-10-21 Stage 2: design baseline and repo layout
2026-10-21 Electronics: SUTRA puck + SURANG avionics schematics (KiCad 10, ERC clean), pin map, power budget, BOM
    [bom.csv, surang-avionics-bom-kicad.csv, surang-avionics.kicad_sch, sutra-puck-bom-kicad.csv, sutra-puck.kicad_sch]
2026-10-24 CAD, renders and cage FEA for Stage 2
    - FreeCAD 1.1 parametric model with STEP/STL exports, mass properties,
    clearance and puck-exit analysis (cad/)
    - Assembly, exploded, cut-away, dimension and puck-exit renders (renders/)
    - Nonlinear cage impact FEA across 6 design variants and 4 hub types,
    mesh convergence, axle/bearing/arm checks and figures (fea/)
    - DESIGN-BASELINE.md: Stage 2 changes found by the analysis
    [SURANG-SUTRA-assembly.step, SURANG-SUTRA.FCStd, assembly.obj, cage-hub-m6.stl, cage-hub-v5.step, cage-hub-v5.stl, cage-hub.step, cage.step]
